rcapaverde/z80board/doc/Z80_schematics/74hc244_Joypad_schematics.PNG

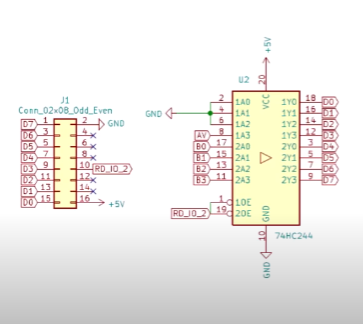
doc/Z80_schematics/74hc244_Joypad_schematics.PNG
