rcapaverde/z80board/doc/Z80_schematics/KEYBOARD_55_KEYS_v1.0_schema-1.png

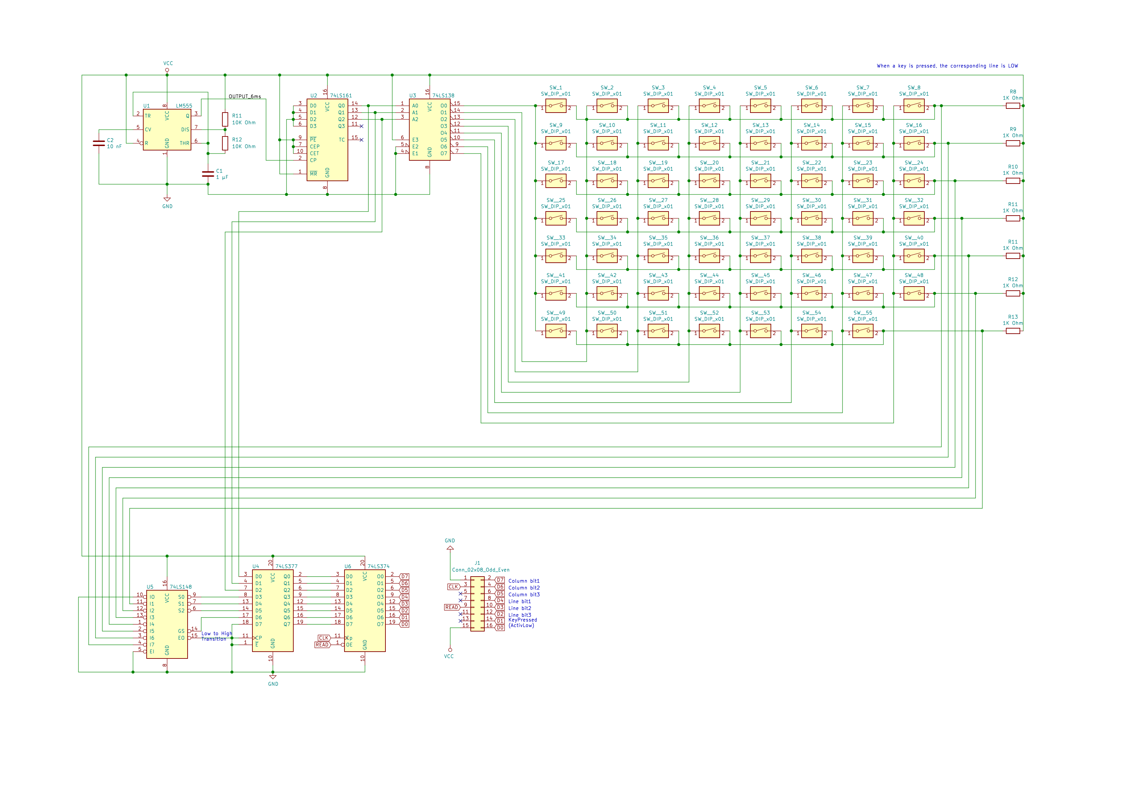
doc/Z80_schematics/KEYBOARD_55_KEYS_v1.0_schema-1.png
