rcapaverde/z80board/doc/Z80_schematics/kicad_schematics-1.png

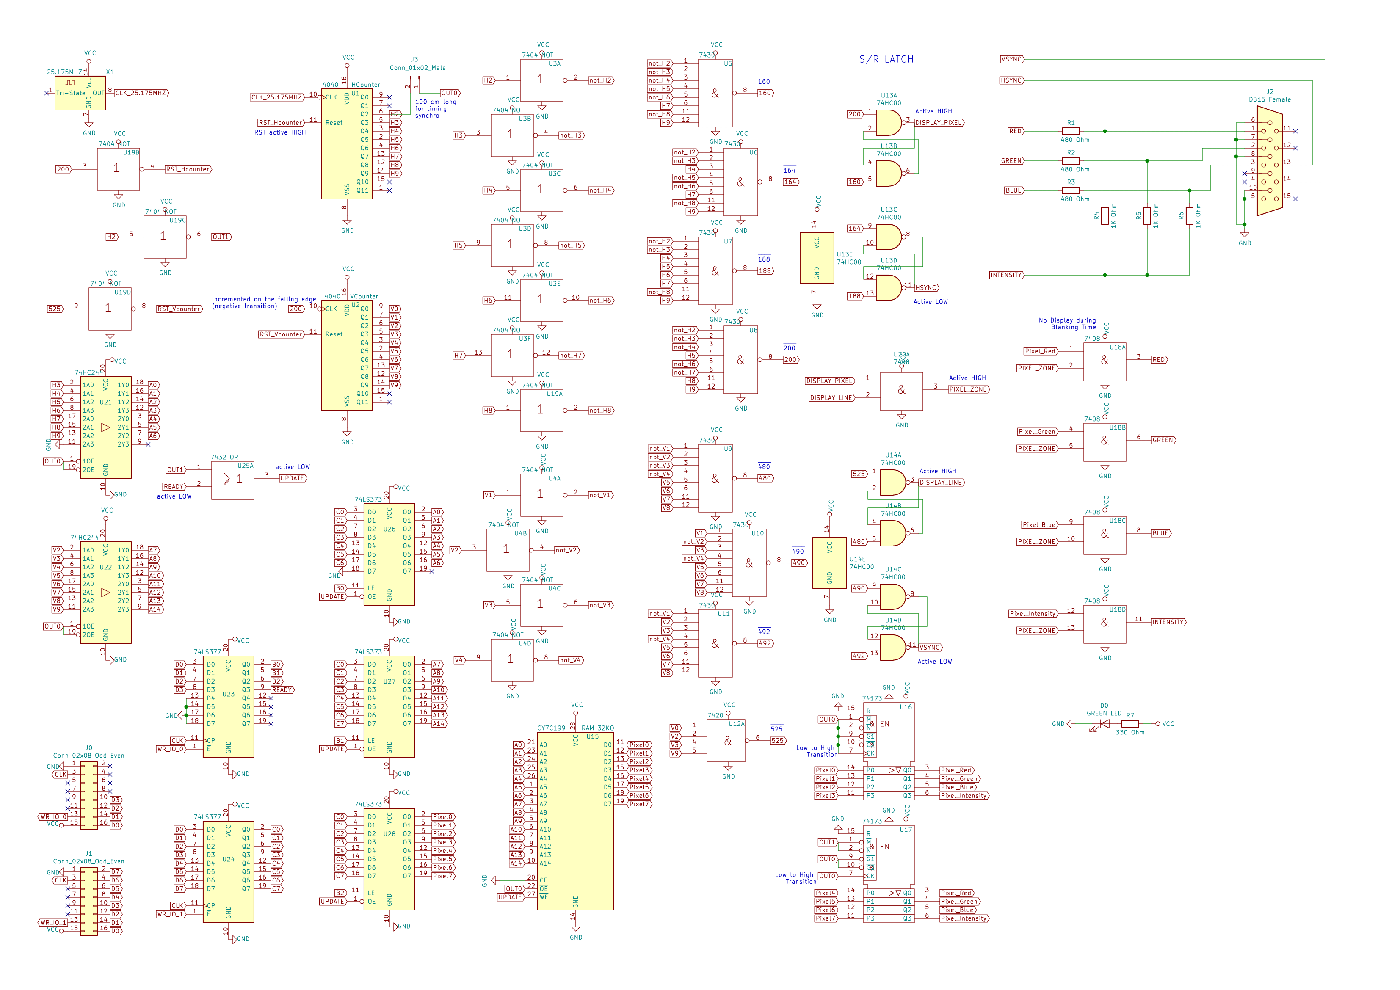
doc/Z80_schematics/kicad_schematics-1.png
