rcapaverde/z80board/doc/Z80_schematics/Keypad_interface.pdf

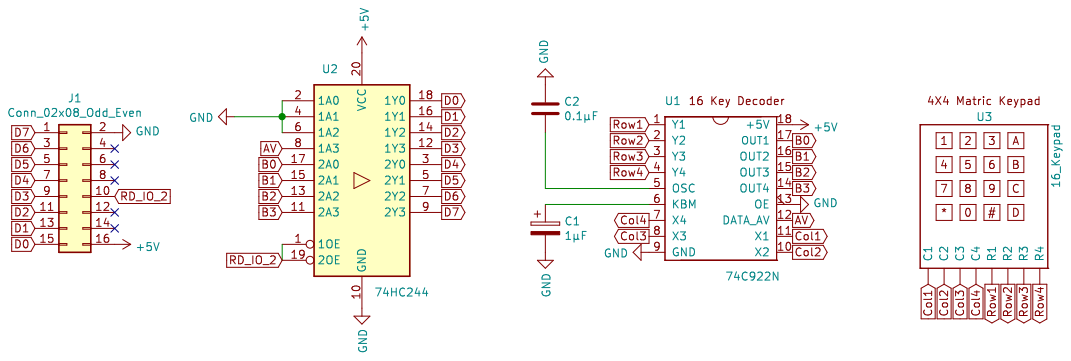
[picture p4: page 1]
