rcapaverde/z80board/doc/Z80_schematics/LCD_128x64_interface.pdf

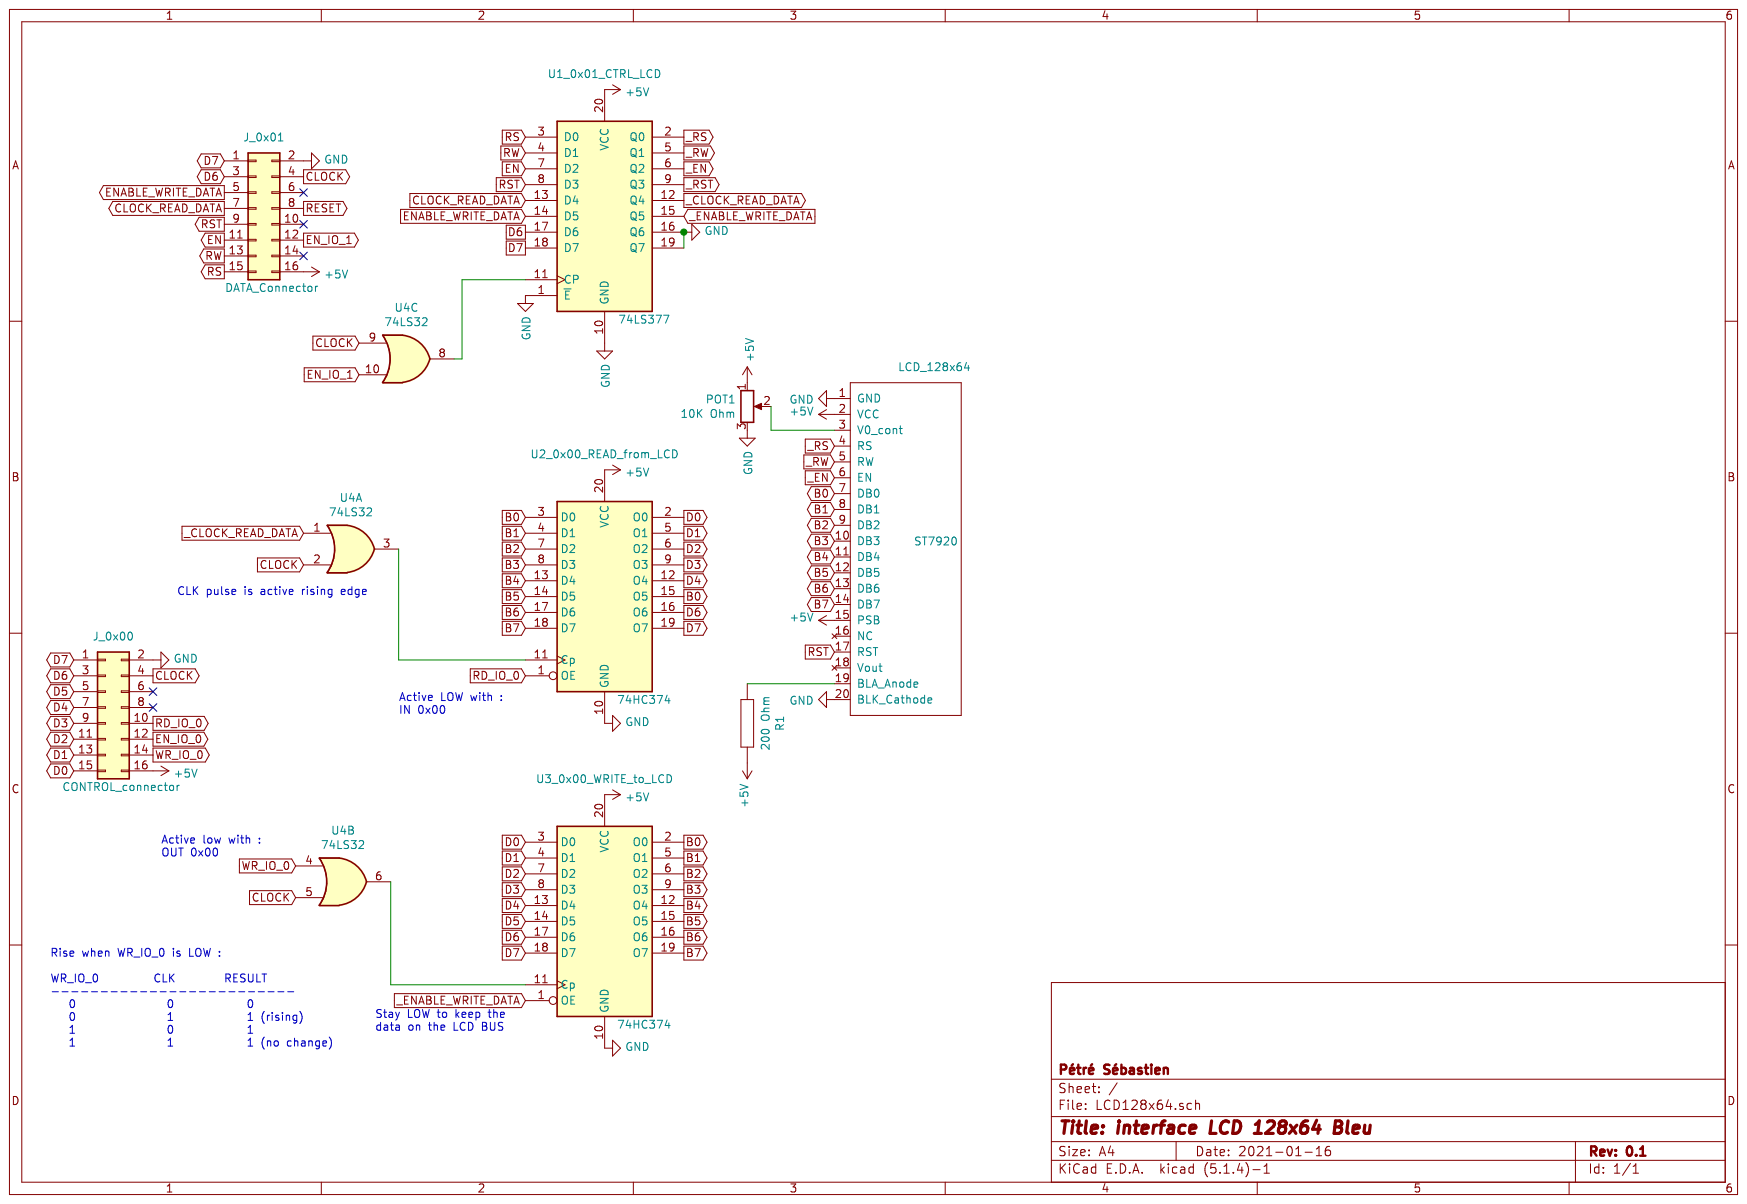
[picture p5: page 1]
