rcapaverde/z80board/doc/Z80_schematics/LCD_128x64_WriteOnly_interface.pdf

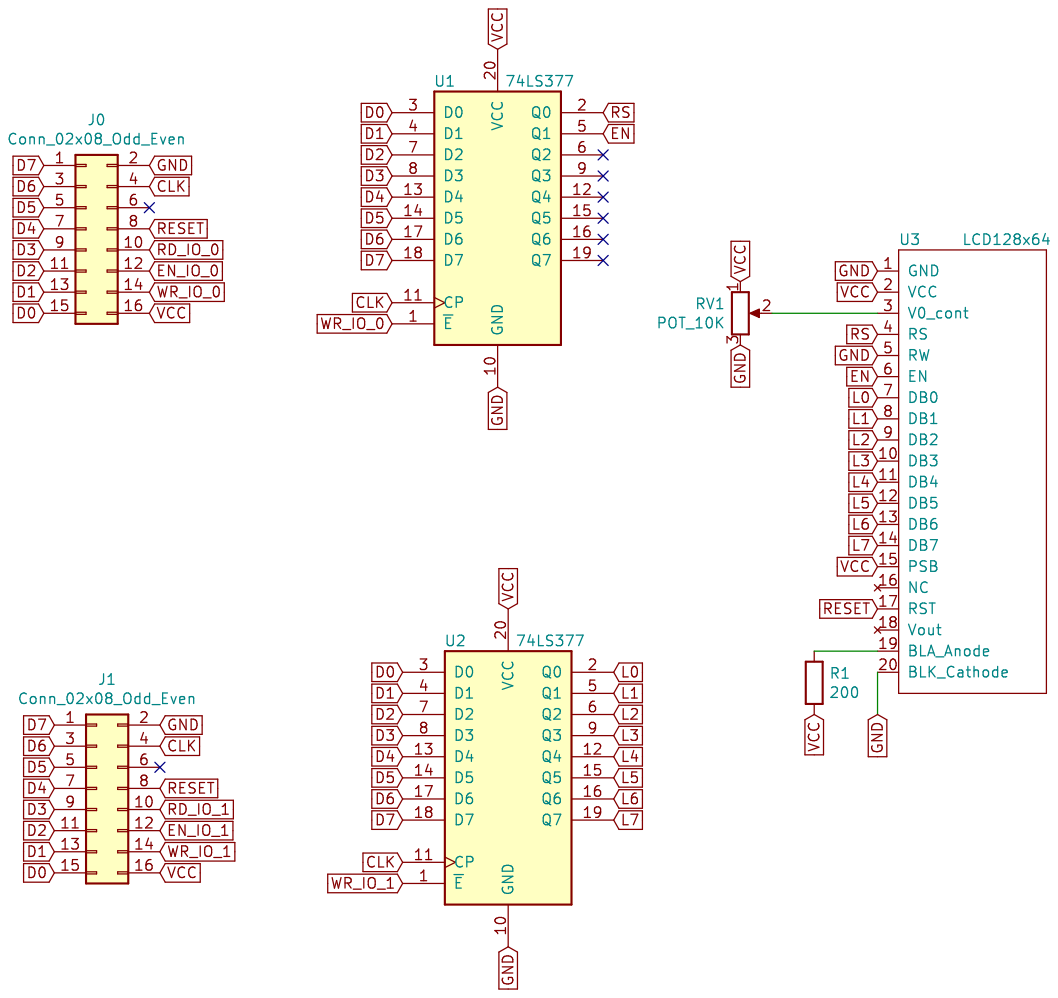
[picture p6: page 1]
