rcapaverde/z80board/doc/Z80_schematics/LCD_20x04_interface.pdf

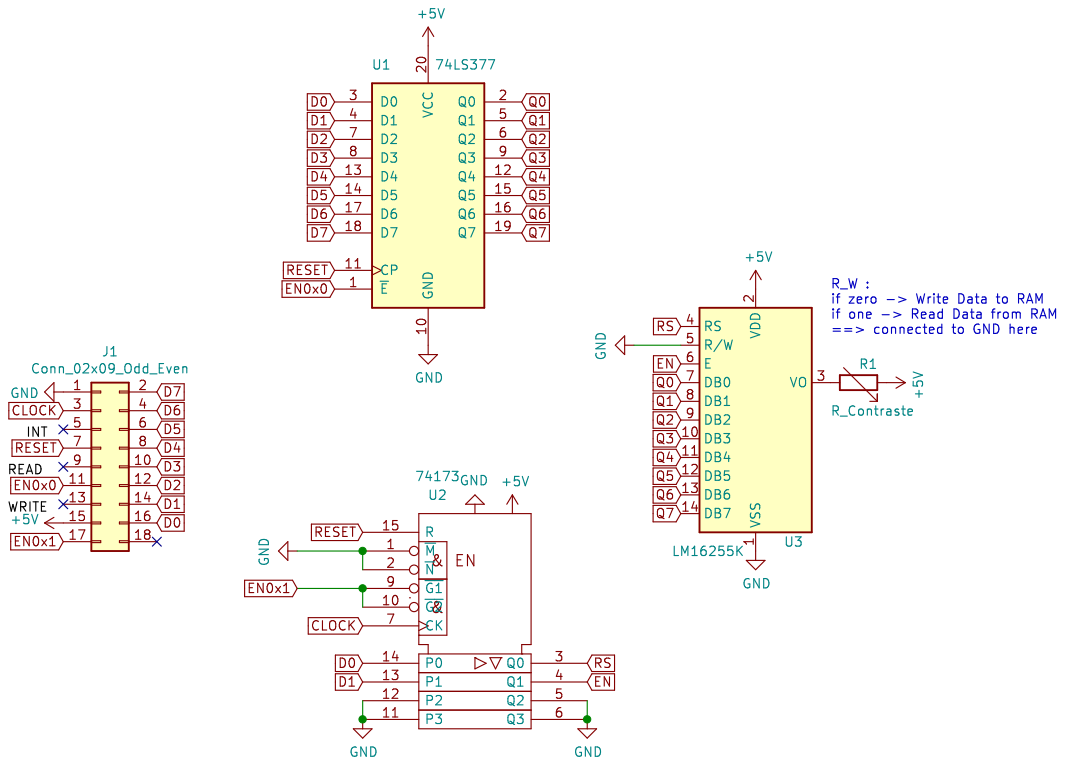
[picture p7: page 1]
