rcapaverde/z80board/doc/Z80_schematics/LED_test_interface.pdf

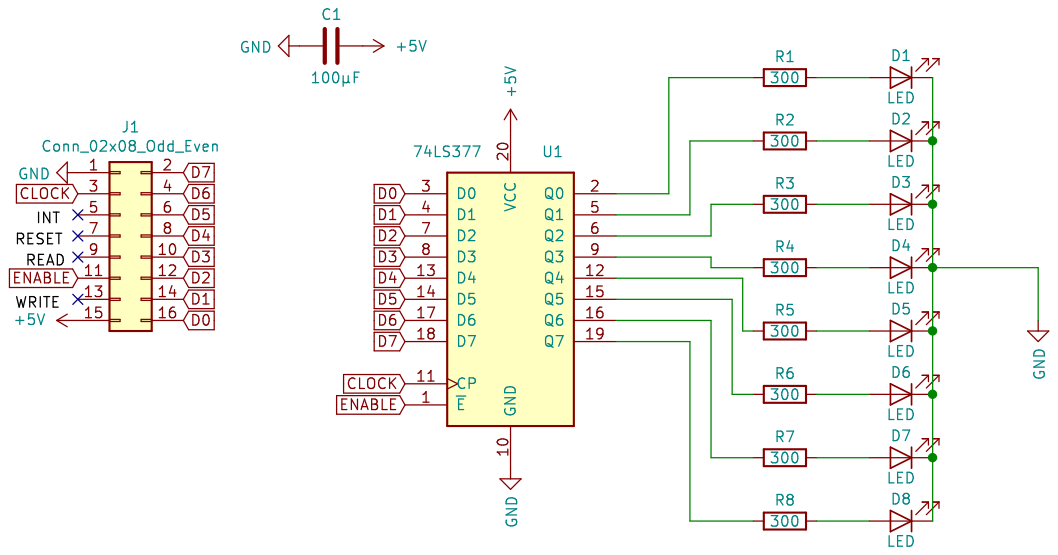
[picture p8: page 1]
