rcapaverde/z80board/doc/Z80_schematics/reset_V2.pdf

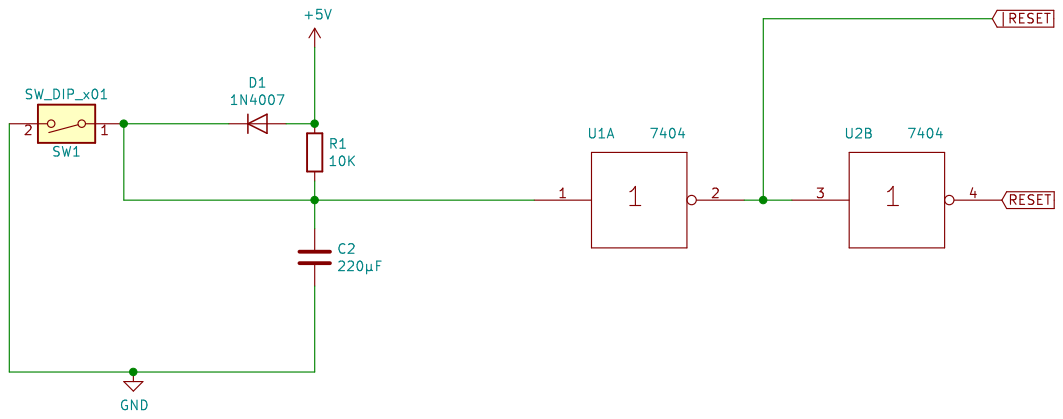
[picture p9: page 1]
