rcapaverde/z80board/doc/Z80_schematics/Schema_Rom_64kbyte_v0.3_img.pdf

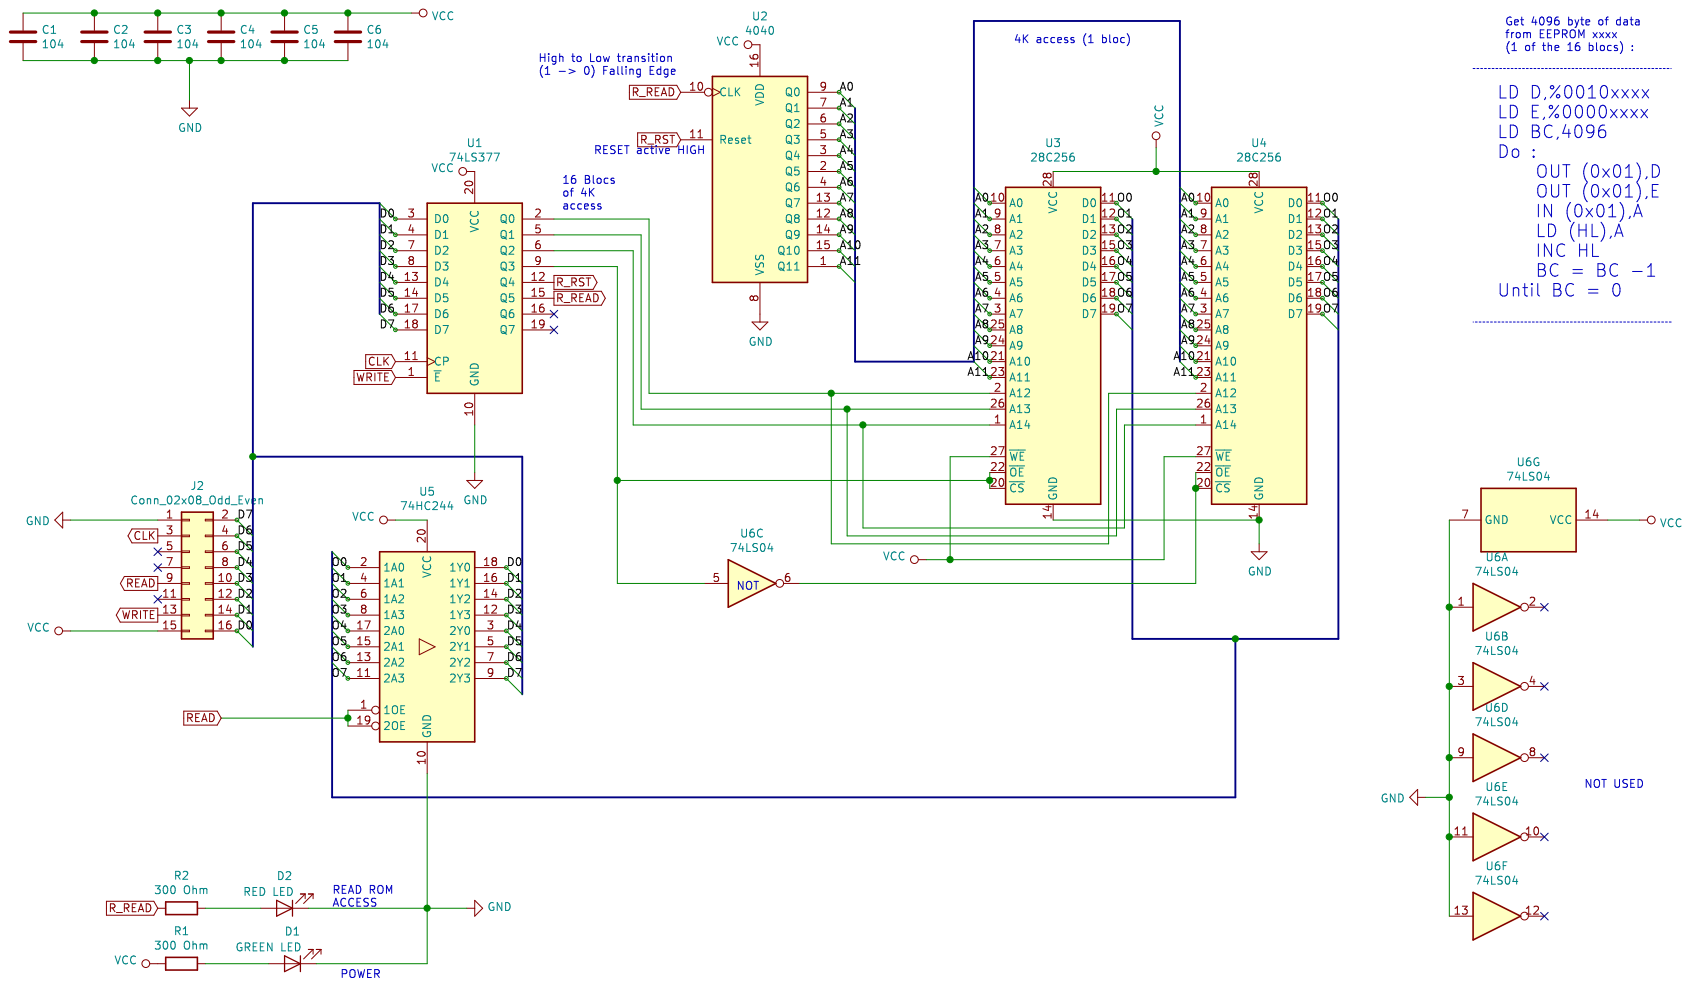
[picture p10: page 1]
