rcapaverde/z80board/doc/Z80_schematics/Speaker_interface.pdf

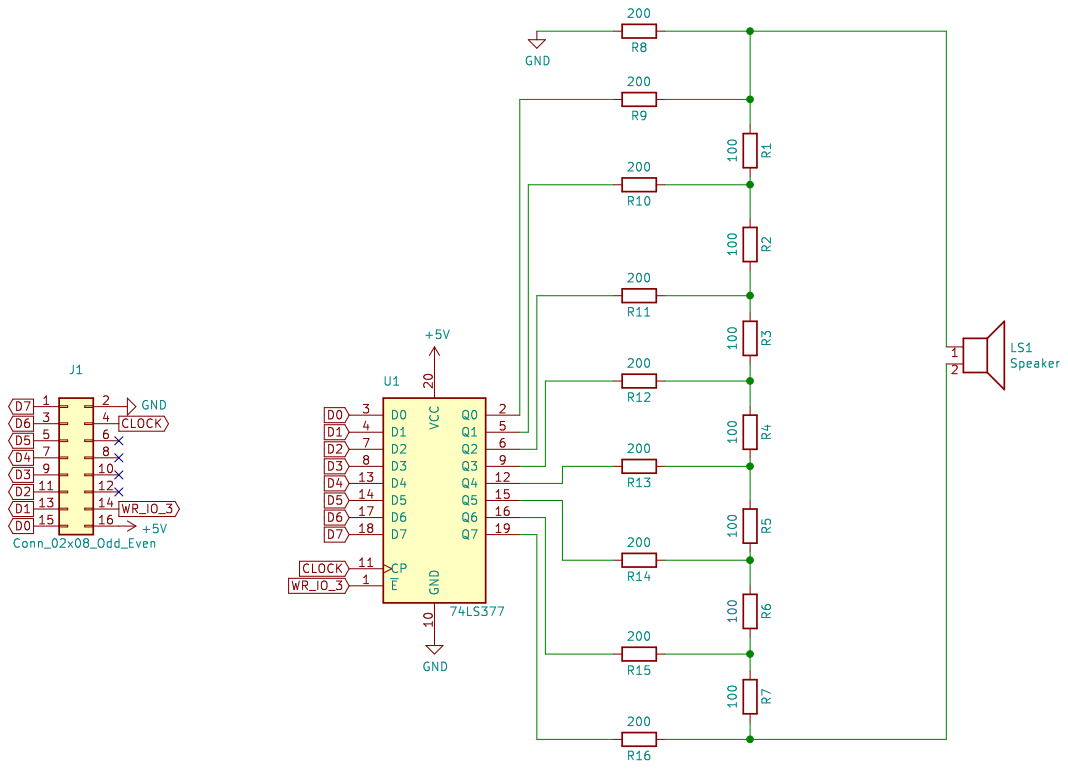
[picture p11: page 1]
