rcapaverde/z80board/doc/Z80_schematics/Video_display_160x120x16c_V1.3.pdf

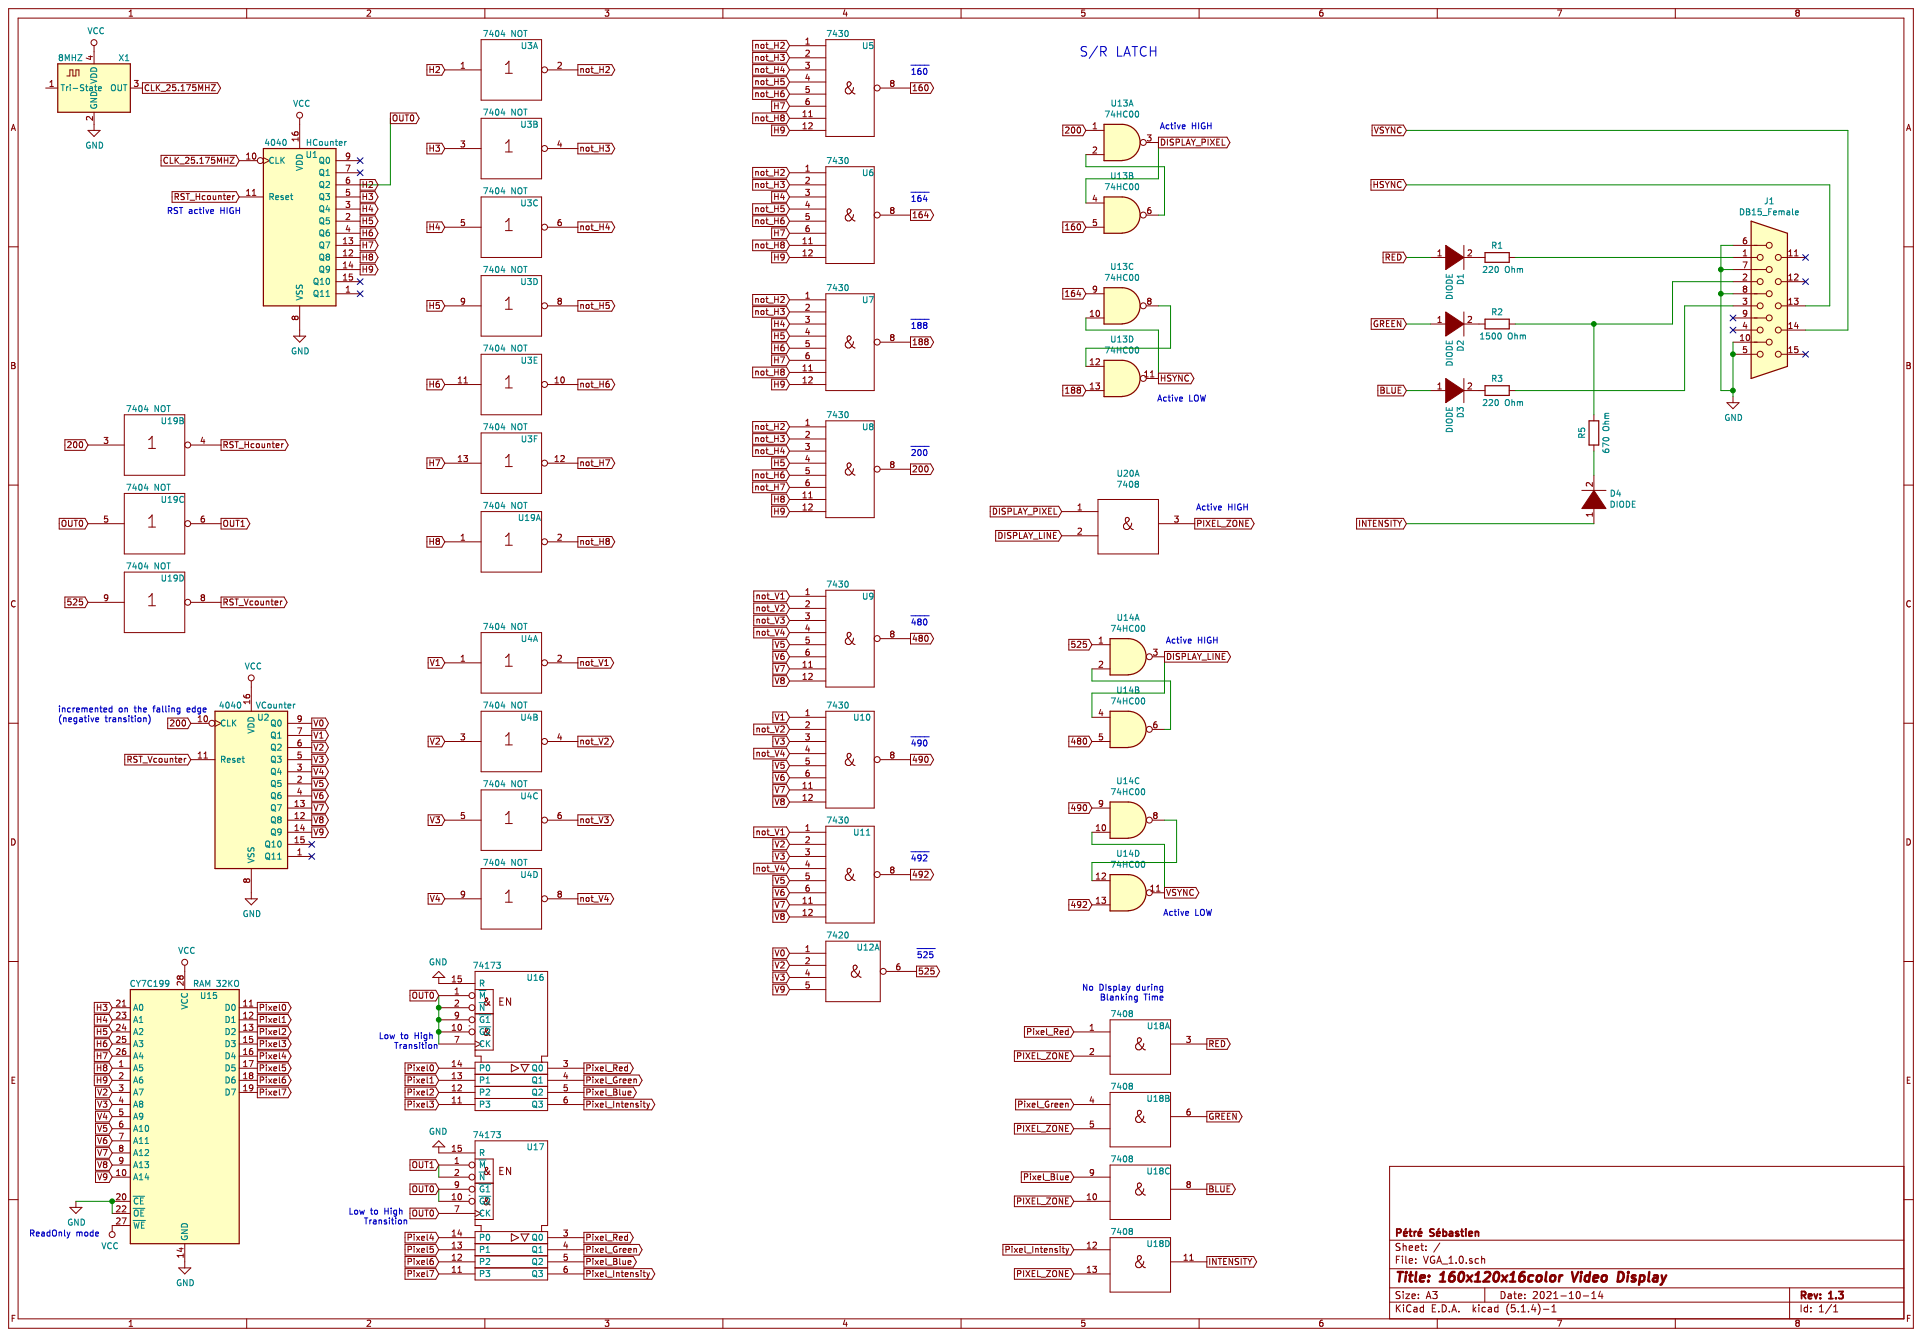
[picture p12: page 1]
