rcapaverde/z80board/doc/Z80_schematics/Video_display_160x120x16c_Z80_connexion_V1.5.pdf

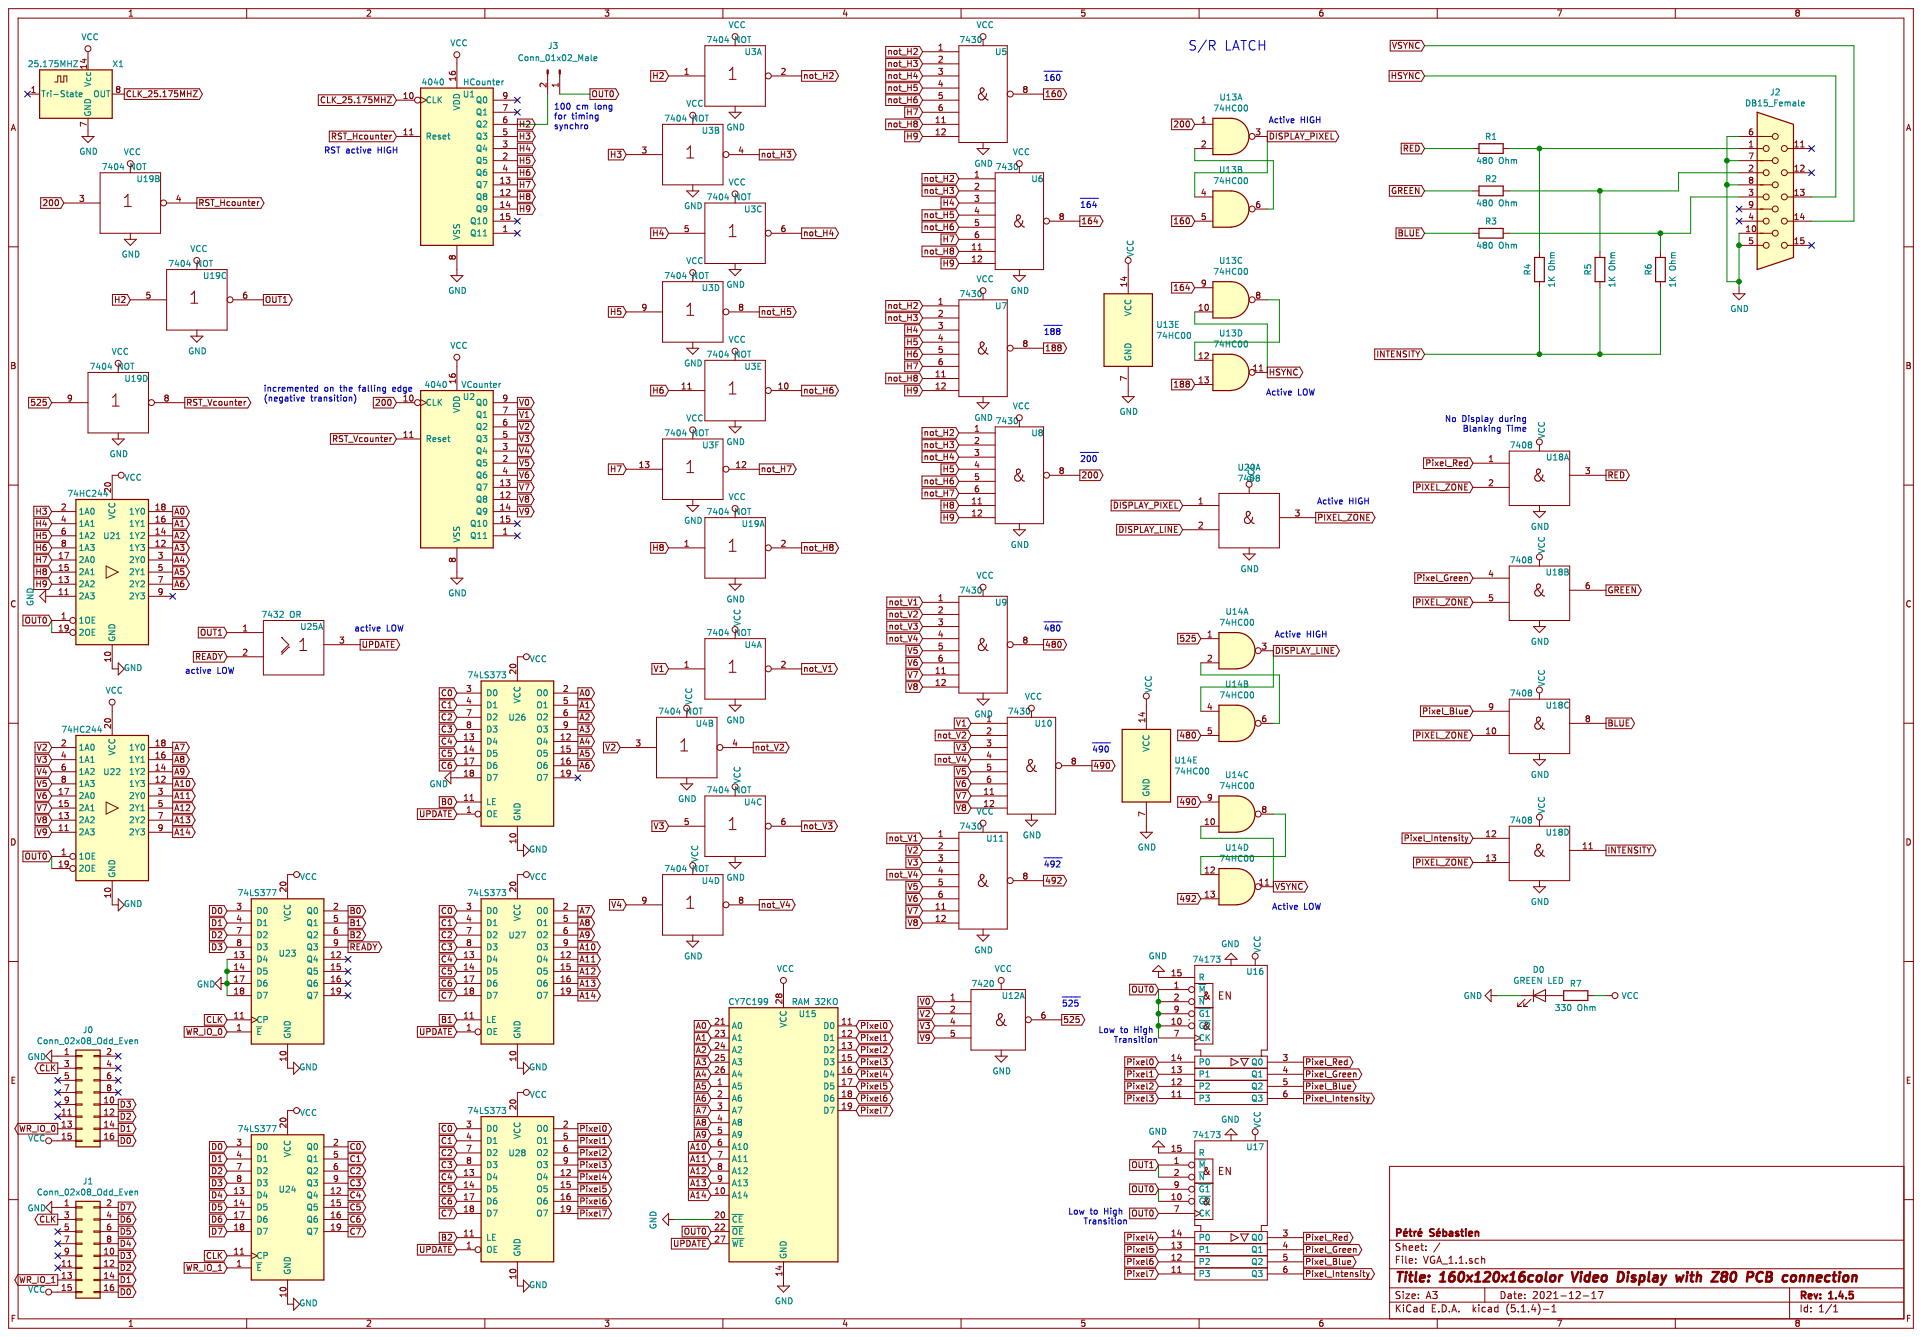
[picture p13: page 1]
