rcapaverde/z80board/doc/Z80_schematics/YM2413_v1.0.pdf

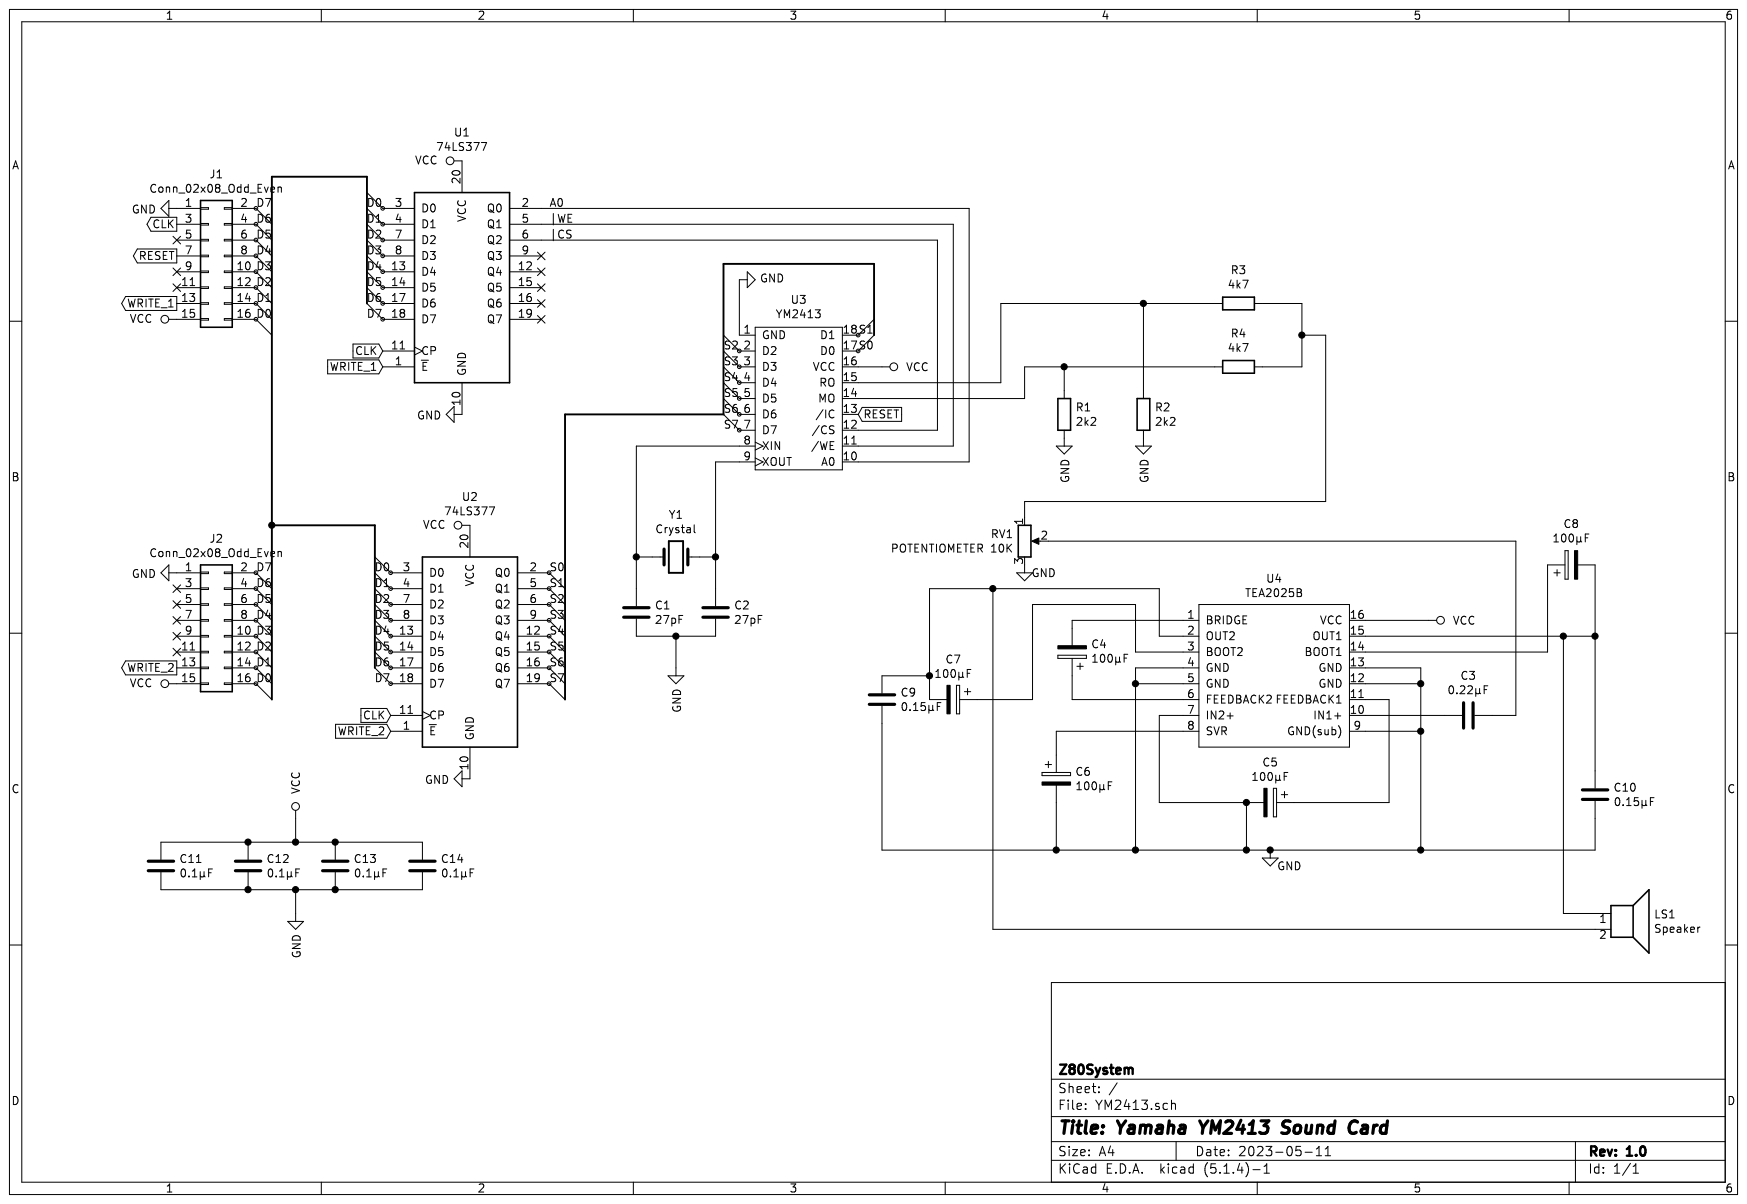
[picture p14: page 1]
