rcapaverde/z80board/doc/Z80_schematics/Z80_Motherboard.pdf

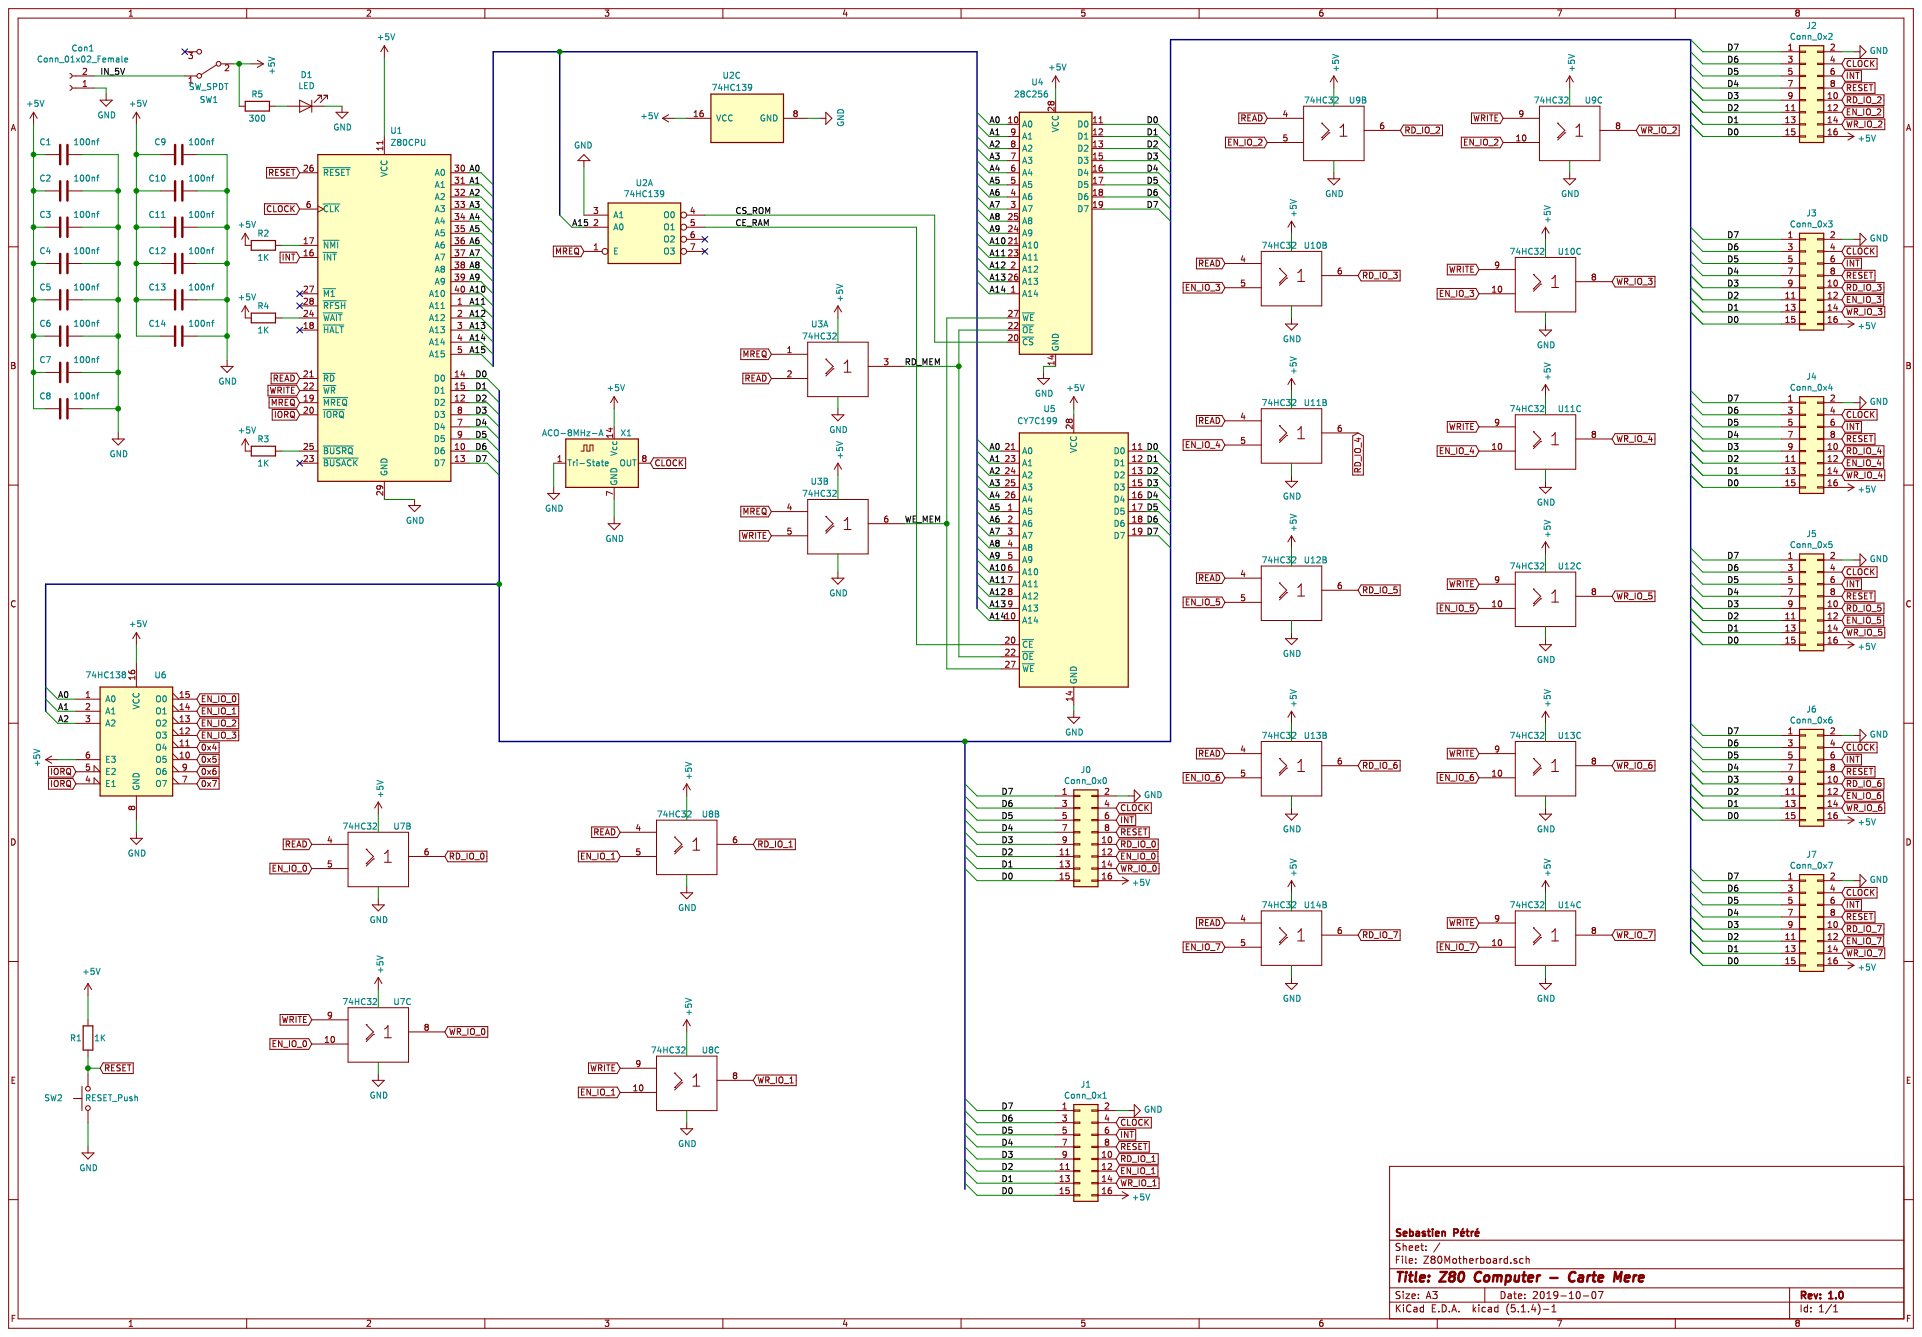
[picture p15: page 1]
