rcapaverde/z80board/doc/Z80_schematics/Z80_Motherboard_V2.pdf

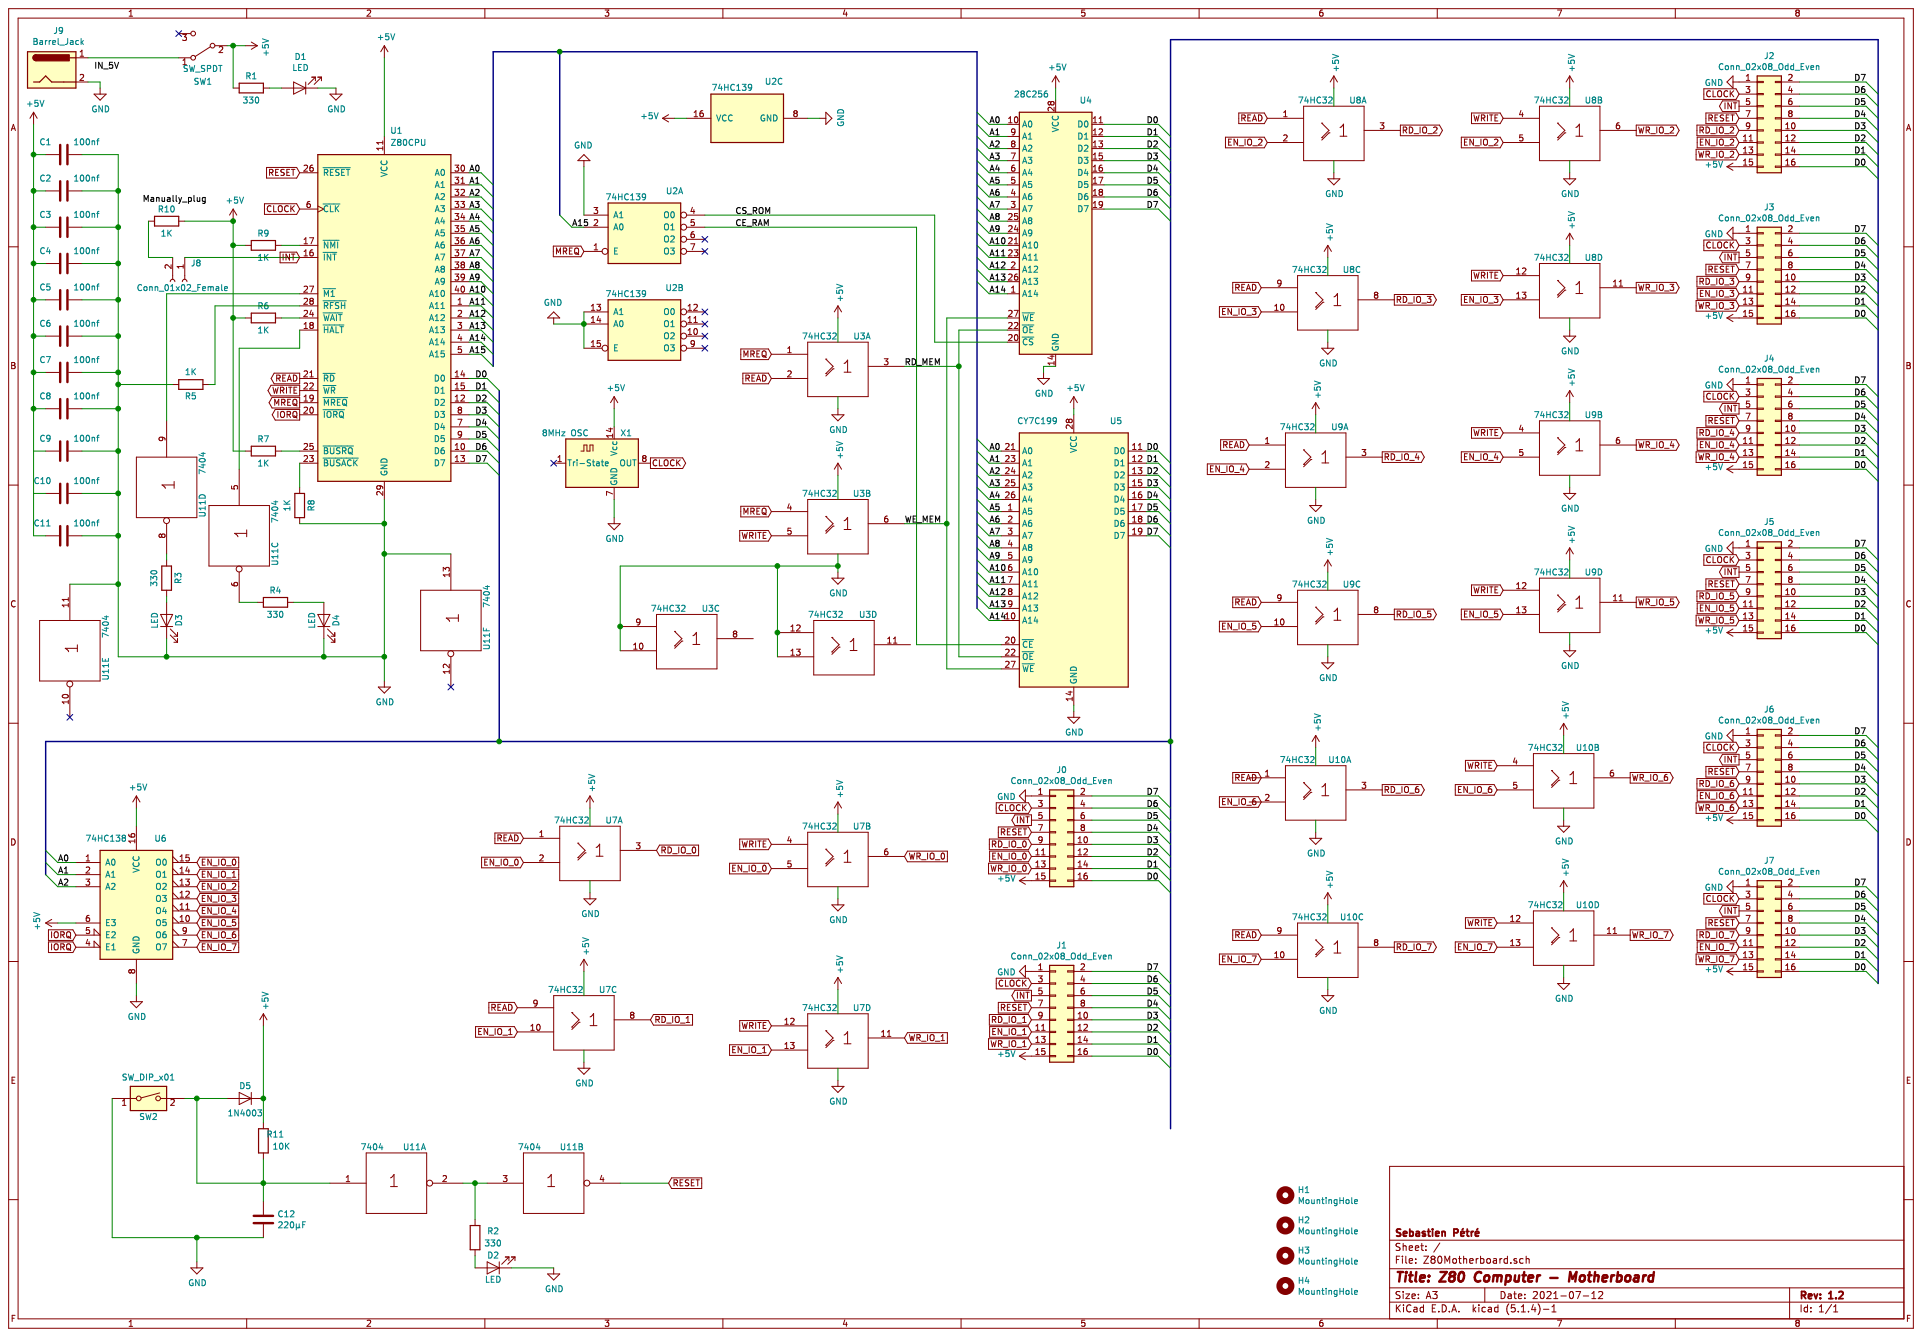
[picture p16: page 1]
