rcapaverde/z80board/doc/Z80_schematics/reset_old.pdf

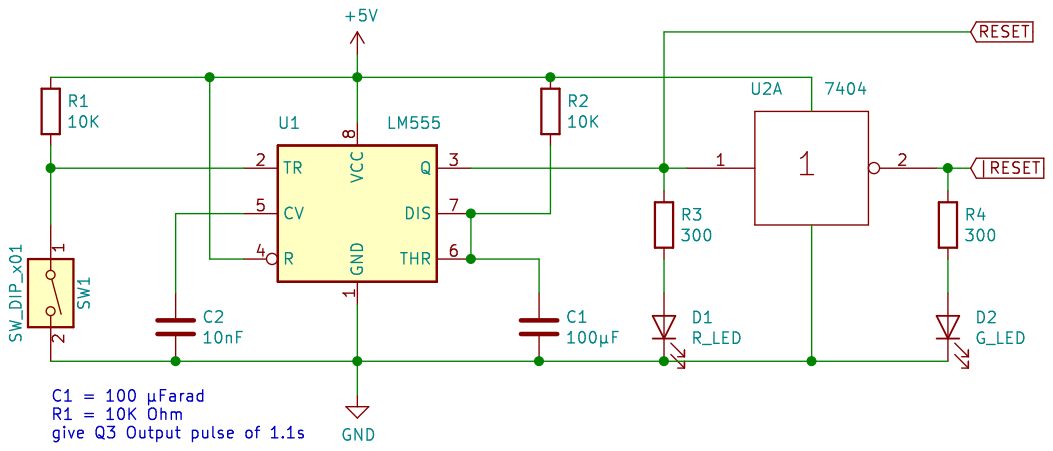
[picture p17: page 1]
