rcapaverde/z80board/pcb_v0/mainboard_v0/mainboard_v0.kicad_pcb

## KiCad design pcb_v0/mainboard_v0/mainboard_v0.kicad_pcb (2026-08-21)

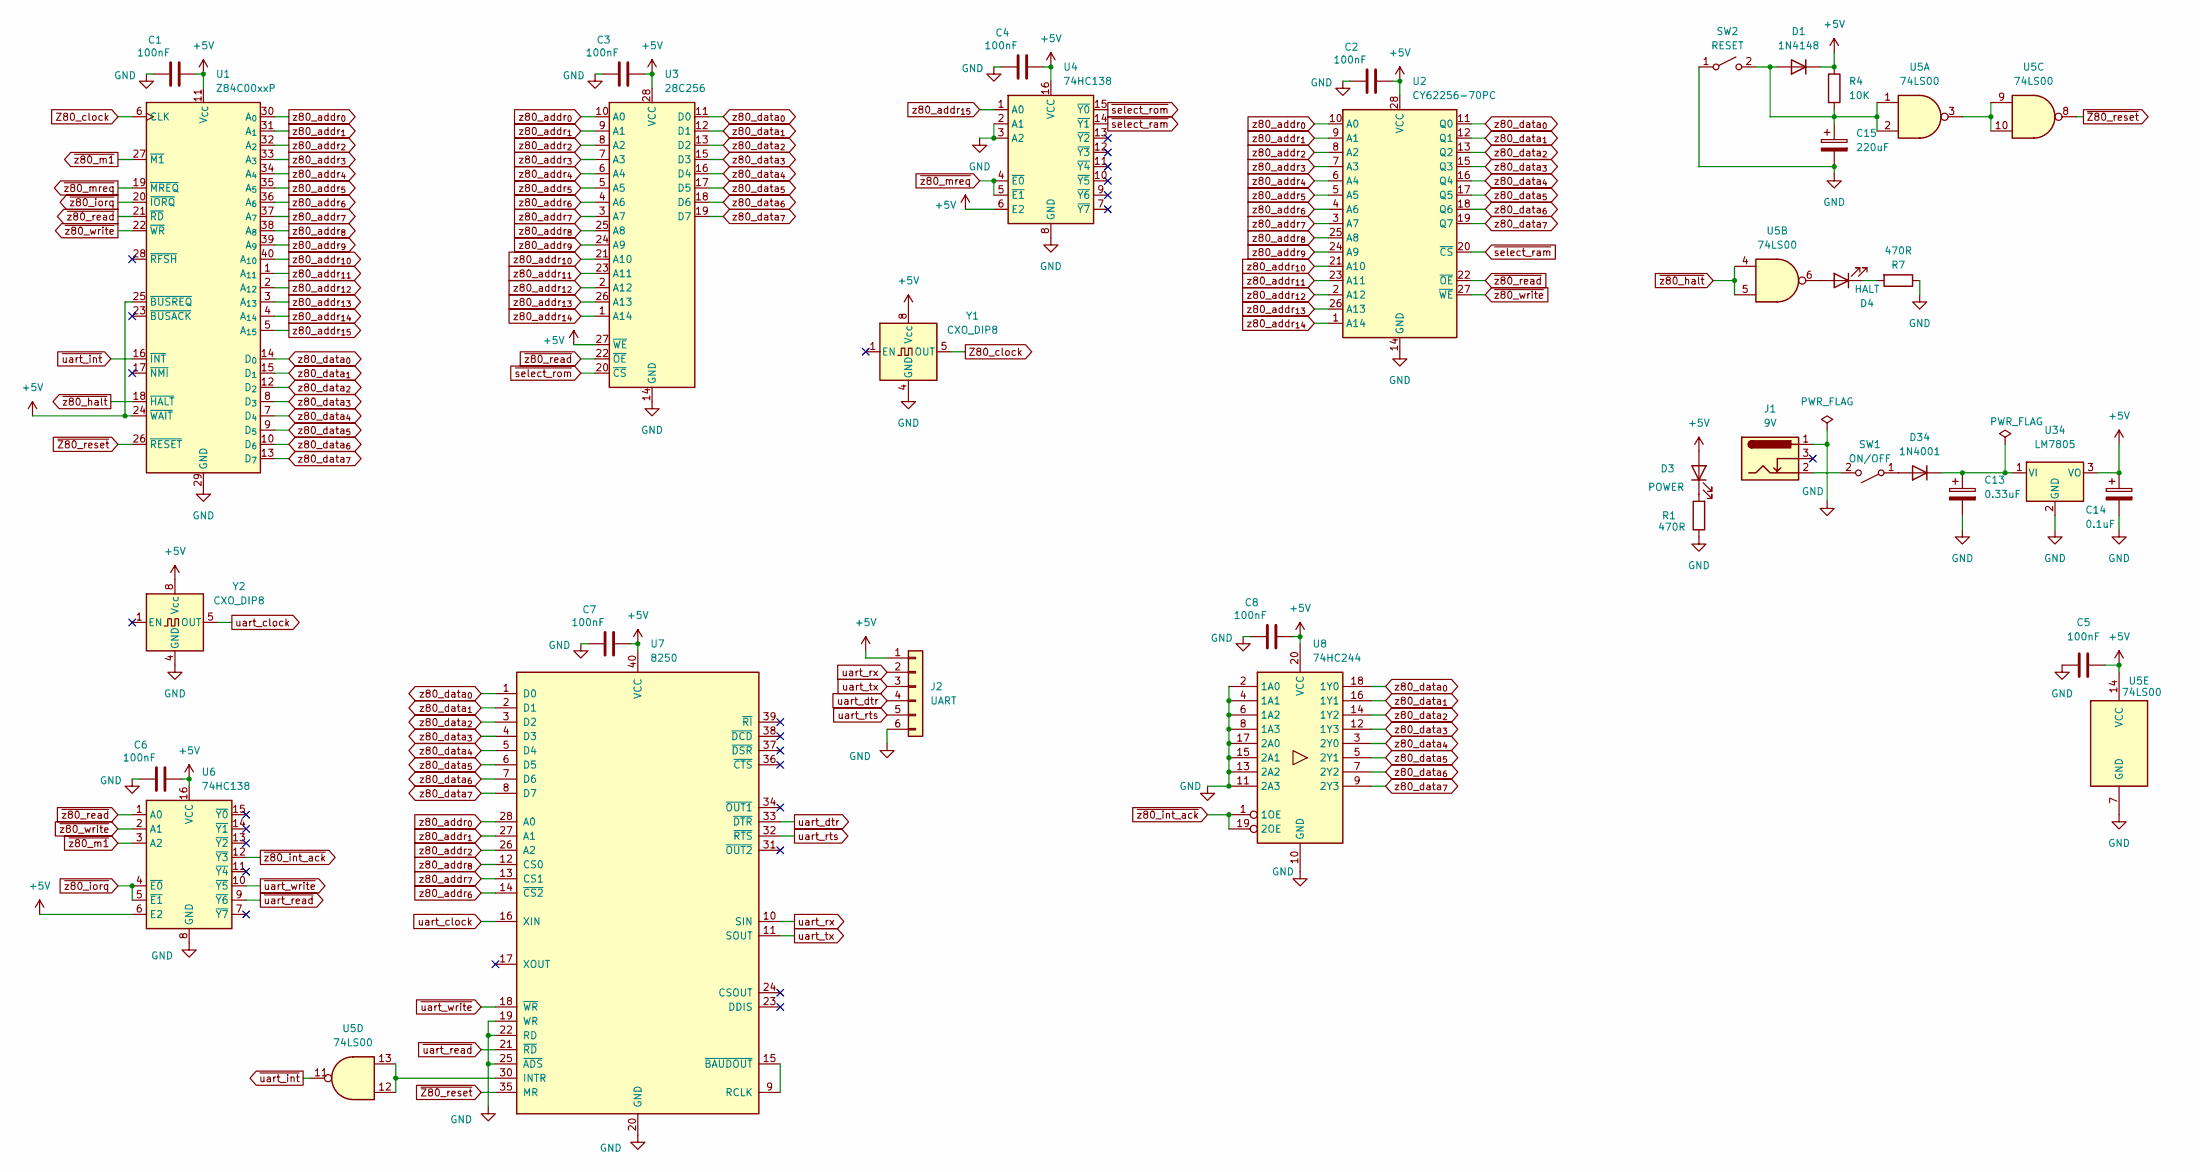
[picture p19: schematic mainboard_v0.kicad_sch]

Parts:
C1, C2, C3, C4, C5, C6, C7, C8: 100nF; C_Disc_D5.1mm_W3.2mm_P5.00mm
C13: 0.33uF; CP_Radial_D5.0mm_P2.50mm
C14: 0.1uF; CP_Radial_D5.0mm_P2.50mm
C15: 220uF; C_Disc_D5.1mm_W3.2mm_P5.00mm
D1: 1N4148; D_DO-35_SOD27_P7.62mm_Horizontal
D3: POWER; LED_D5.0mm
D4: HALT; LED_D5.0mm
D34: 1N4001; D_DO-41_SOD81_P10.16mm_Horizontal
J1: 9V; BarrelJack_Horizontal
J2: UART; PinHeader_1x06_P2.54mm_Vertical
R1, R7: 470R; R_Axial_DIN0207_L6.3mm_D2.5mm_P7.62mm_Horizontal
R4: 10K; R_Axial_DIN0207_L6.3mm_D2.5mm_P7.62mm_Horizontal
SW1: ON/OFF; jrx
SW2: RESET; SW_PUSH_6mm
U1: Z84C00xxP; DIP-40_W15.24mm
U2: CY62256-70PC; DIP-28_W15.24mm
U3: 28C256; DIP_Socket-28_W6.9mm_W7.62mm_W10.16mm_W12.7mm_W13.5mm_3M_22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
U4, U6: 74HC138; DIP-16_W7.62mm
U5: 74LS00; DIP-14_W7.62mm
U7: 8250; DIP-40_W15.24mm
U8: 74HC244; DIP-20_W7.62mm
U34: LM7805; TO-220-3_Vertical
Y1, Y2: CXO_DIP8; Oscillator_DIP-8

Connections:
+5V: C1.2, C2.2, C3.2, C4.2, C5.2, C6.2, C7.2, C8.2, C14.1, D1.1 (K), D3.2 (A), J2.1, R4.1, U1.11 (V_{CC}), U1.24 (~WAIT), U1.25 (~BUSREQ), U2.28 (VCC), U3.27 (~WE), U3.28 (VCC), U4.6 (E2), U4.16 (VCC), U5.14 (VCC), U6.6 (E2), U6.16 (VCC), U7.40 (VCC), U8.20 (VCC), U34.3 (VO), Y1.8 (Vcc), Y2.8 (Vcc)
GND: C1.1, C2.1, C3.1, C4.1, C5.1, C6.1, C7.1, C8.1, C13.2, C14.2, C15.2, J1.1, J2.6, R1.1, R7.1, SW2.1 (A), U1.29 (GND), U2.14 (GND), U3.14 (GND), U4.2 (A1), U4.3 (A2), U4.8 (GND), U5.7 (GND), U6.8 (GND), U7.19 (WR), U7.20 (GND), U7.22 (RD), U7.25 (~ADS), U8.2 (1A0), U8.4 (1A1), U8.6 (1A2), U8.8 (1A3), U8.10 (GND), U8.11 (2A3), U8.13 (2A2), U8.15 (2A1), U8.17 (2A0), U34.2 (GND), Y1.4 (GND), Y2.4 (GND)
unnamed: C15.1, D1.2 (A), R4.2, SW2.2 (B), U5.1, U5.2
unnamed: D3.1 (K), R1.2
unnamed: D4.2 (A), U5.6
unnamed: D4.1 (K), R7.2
unnamed: D34.2 (A), SW1.1 (A)
unnamed: C13.1, D34.1 (K), U34.1 (VI)
unnamed: J1.2, SW1.2 (B)
unnamed: U5.3, U5.9, U5.10
unnamed: U5.12, U5.13, U7.30 (INTR)
unnamed: U7.9 (RCLK), U7.15 (~BAUDOUT)
Z80_clock: U1.6 (CLK), Y1.5 (OUT)
uart_clock: U7.16 (XIN), Y2.5 (OUT)
uart_dtr: J2.4, U7.33 (~DTR)
uart_rts: J2.5, U7.32 (~RTS)
uart_rx: J2.2, U7.10 (SIN)
uart_tx: J2.3, U7.11 (SOUT)
z80_addr_{0}: U1.30 (A_{0}), U2.10 (A0), U3.10 (A0), U7.28 (A0)
z80_addr_{1}: U1.31 (A_{1}), U2.9 (A1), U3.9 (A1), U7.27 (A1)
z80_addr_{2}: U1.32 (A_{2}), U2.8 (A2), U3.8 (A2), U7.26 (A2)
z80_addr_{3}: U1.33 (A_{3}), U2.7 (A3), U3.7 (A3)
z80_addr_{4}: U1.34 (A_{4}), U2.6 (A4), U3.6 (A4)
z80_addr_{5}: U1.35 (A_{5}), U2.5 (A5), U3.5 (A5)
z80_addr_{6}: U1.36 (A_{6}), U2.4 (A6), U3.4 (A6), U7.14 (~CS2)
z80_addr_{7}: U1.37 (A_{7}), U2.3 (A7), U3.3 (A7), U7.13 (CS1)
z80_addr_{8}: U1.38 (A_{8}), U2.25 (A8), U3.25 (A8), U7.12 (CS0)
z80_addr_{9}: U1.39 (A_{9}), U2.24 (A9), U3.24 (A9)
z80_addr_{10}: U1.40 (A_{10}), U2.21 (A10), U3.21 (A10)
z80_addr_{11}: U1.1 (A_{11}), U2.23 (A11), U3.23 (A11)
z80_addr_{12}: U1.2 (A_{12}), U2.2 (A12), U3.2 (A12)
z80_addr_{13}: U1.3 (A_{13}), U2.26 (A13), U3.26 (A13)
z80_addr_{14}: U1.4 (A_{14}), U2.1 (A14), U3.1 (A14)
z80_addr_{15}: U1.5 (A_{15}), U4.1 (A0)
z80_data_{0}: U1.14 (D_{0}), U2.11 (Q0), U3.11 (D0), U7.1 (D0), U8.18 (1Y0)
z80_data_{1}: U1.15 (D_{1}), U2.12 (Q1), U3.12 (D1), U7.2 (D1), U8.16 (1Y1)
z80_data_{2}: U1.12 (D_{2}), U2.13 (Q2), U3.13 (D2), U7.3 (D2), U8.14 (1Y2)
z80_data_{3}: U1.8 (D_{3}), U2.15 (Q3), U3.15 (D3), U7.4 (D3), U8.12 (1Y3)
z80_data_{4}: U1.7 (D_{4}), U2.16 (Q4), U3.16 (D4), U7.5 (D4), U8.3 (2Y0)
z80_data_{5}: U1.9 (D_{5}), U2.17 (Q5), U3.17 (D5), U7.6 (D5), U8.5 (2Y1)
z80_data_{6}: U1.10 (D_{6}), U2.18 (Q6), U3.18 (D6), U7.7 (D6), U8.7 (2Y2)
z80_data_{7}: U1.13 (D_{7}), U2.19 (Q7), U3.19 (D7), U7.8 (D7), U8.9 (2Y3)
~Z80_reset: U1.26 (~RESET), U5.8, U7.35 (MR)
~select_ram: U2.20 (~CS), U4.14 (~Y1)
~select_rom: U3.20 (~CS), U4.15 (~Y0)
~uart_int: U1.16 (~INT), U5.11
~uart_read: U6.9 (~Y6), U7.21 (~RD)
~uart_write: U6.10 (~Y5), U7.18 (~WR)
~z80_halt: U1.18 (~HALT), U5.4, U5.5
~z80_int_ack: U6.12 (~Y3), U8.1 (1OE), U8.19 (2OE)
~z80_iorq: U1.20 (~IORQ), U6.4 (~E0), U6.5 (~E1)
~z80_m1: U1.27 (~M1), U6.3 (A2)
~z80_mreq: U1.19 (~MREQ), U4.4 (~E0), U4.5 (~E1)
~z80_read: U1.21 (~RD), U2.22 (~OE), U3.22 (~OE), U6.1 (A0)
~z80_write: U1.22 (~WR), U2.27 (~WE), U6.2 (A1)

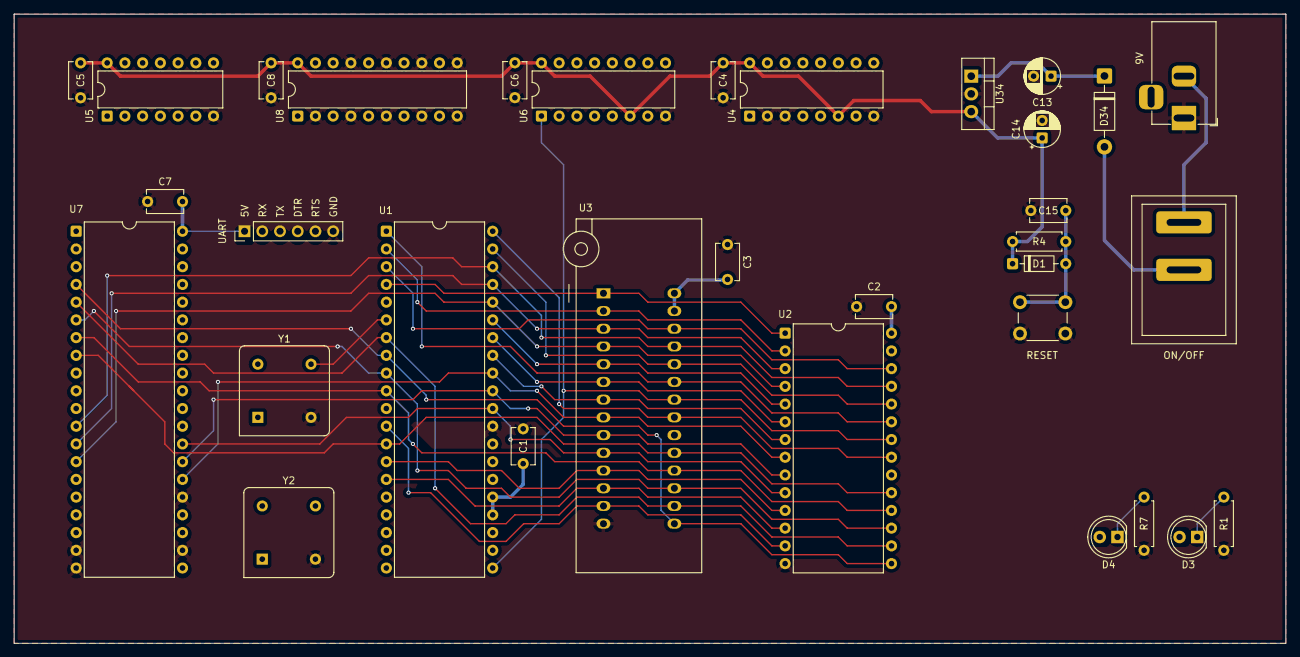
[picture p20: board mainboard_v0.kicad_pcb from above]

Board: 2 copper layers, 182.2 x 90.2 mm, 33 parts (0 on the bottom side), 55 nets.
