rcapaverde/z80board/pcb/mainboard/mainboard.kicad_pcb

## KiCad design pcb/mainboard/mainboard.kicad_pcb (2026-08-15, an earlier design)

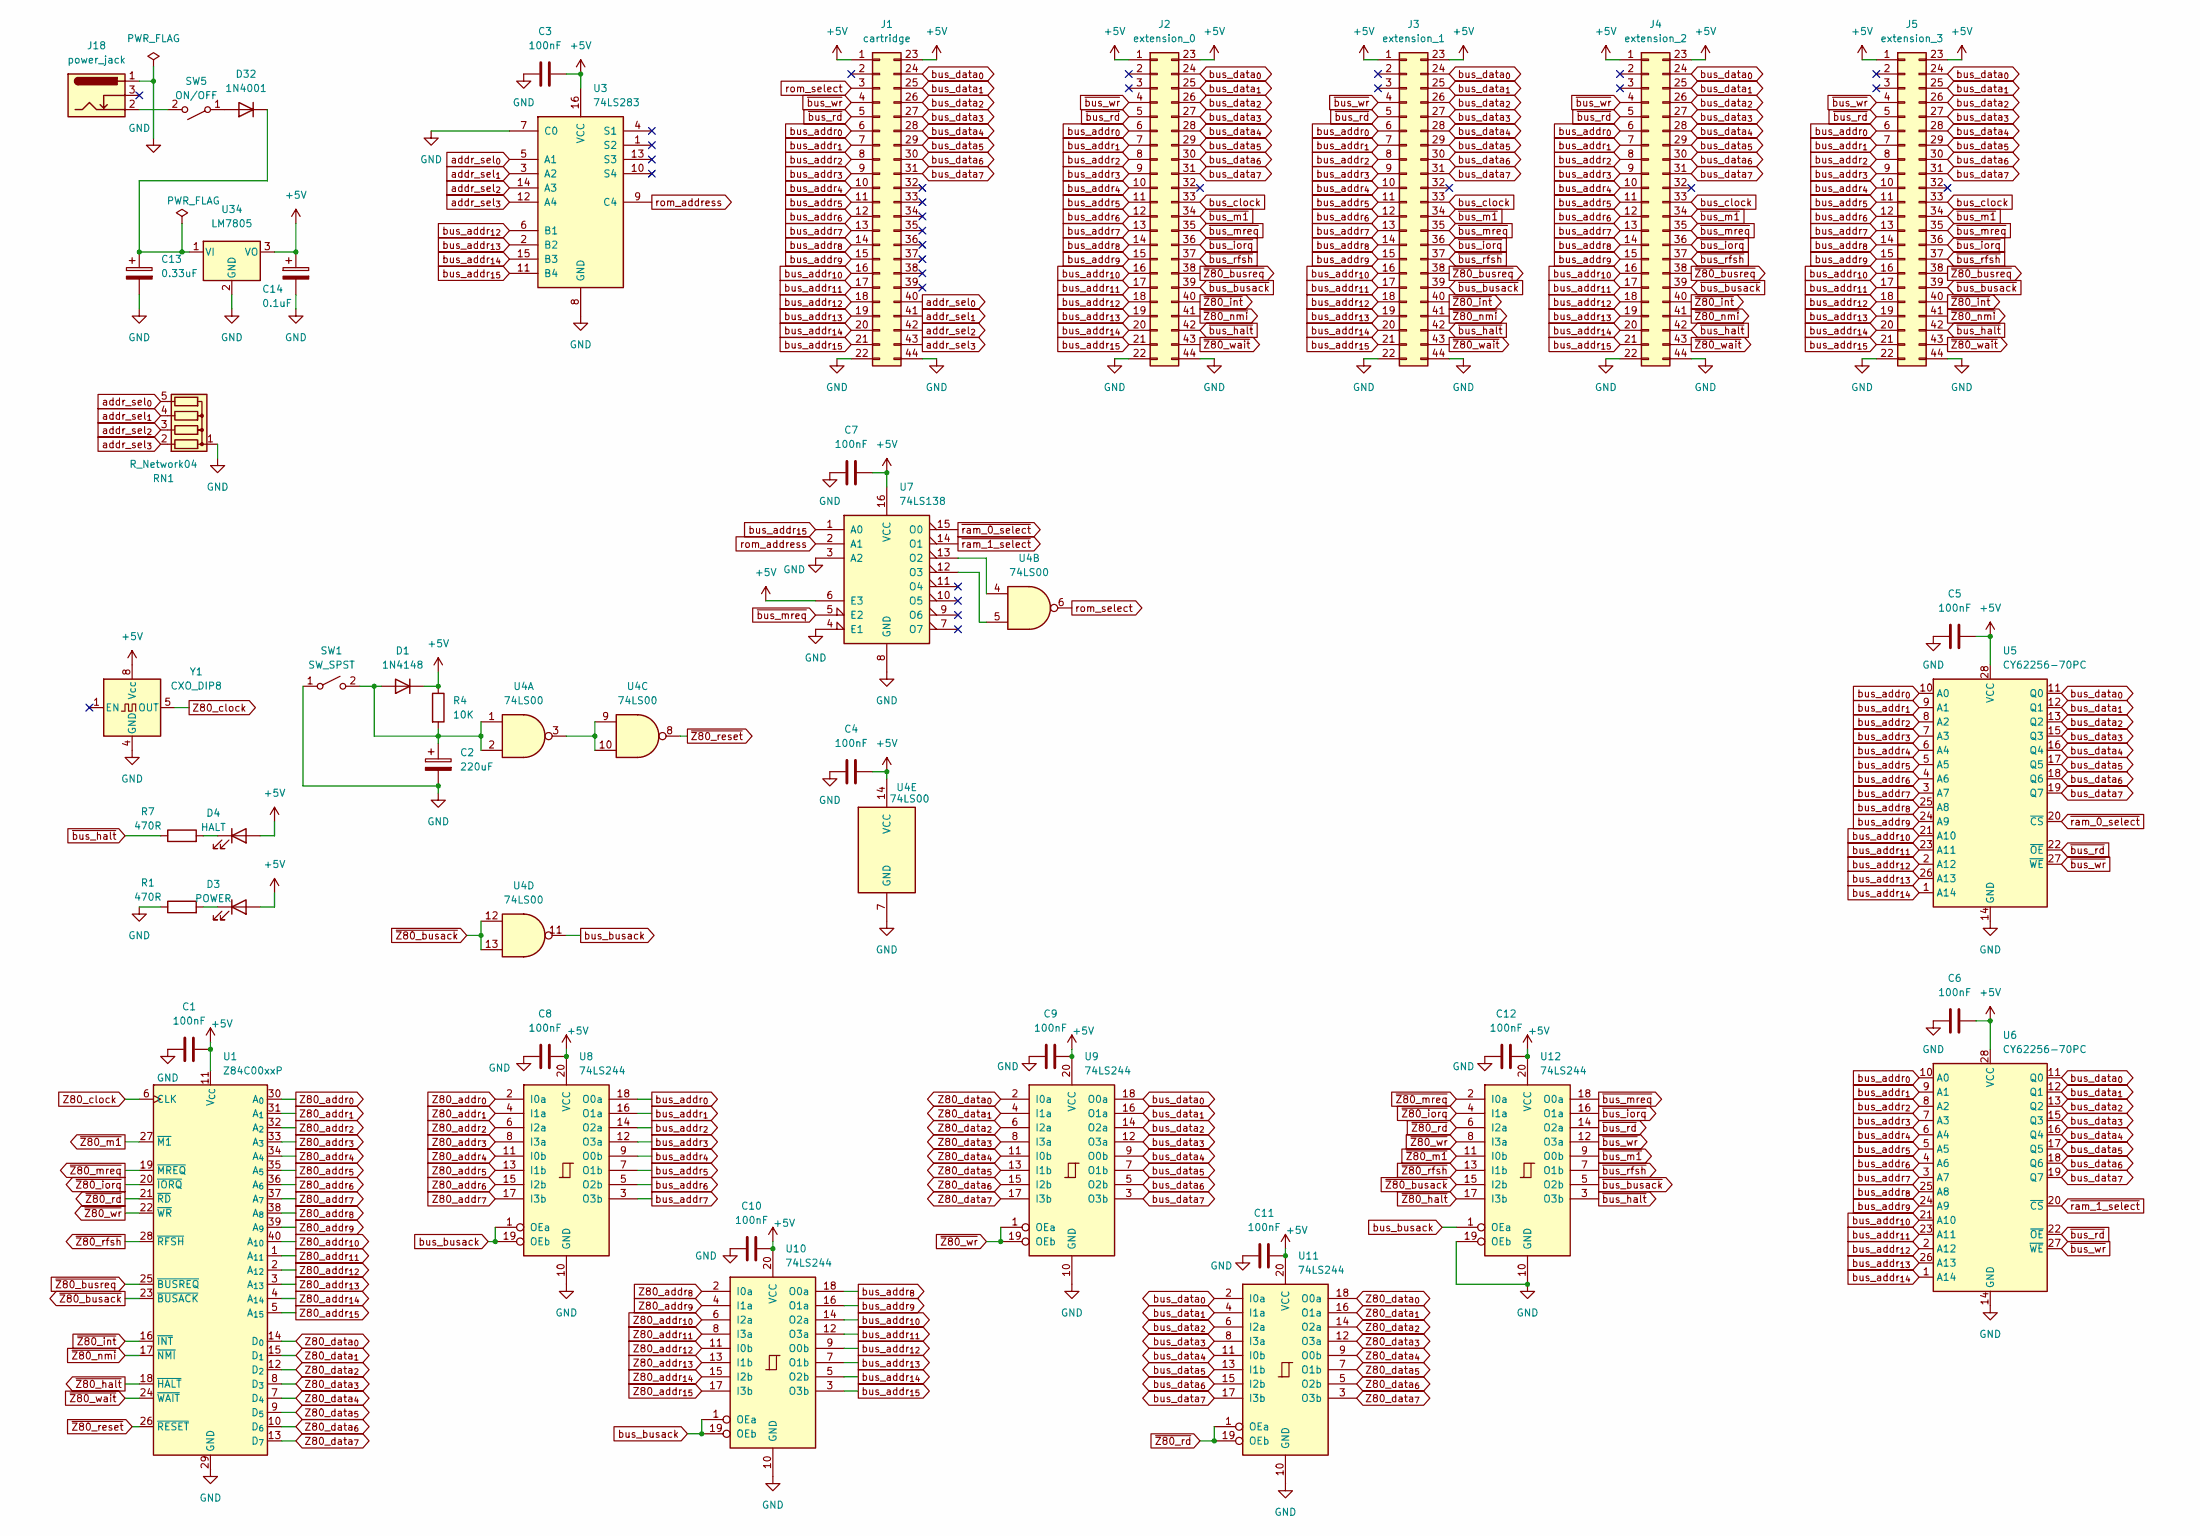
[picture p21: schematic mainboard.kicad_sch]

Parts:
C1, C3, C4, C5, C6, C7, C8, C9, C10, C11, C12: 100nF; C_Disc_D5.1mm_W3.2mm_P5.00mm
C2: 220uF; C_Disc_D5.1mm_W3.2mm_P5.00mm
C13: 0.33uF; CP_Radial_D5.0mm_P2.50mm
C14: 0.1uF; CP_Radial_D5.0mm_P2.50mm
D1: 1N4148; D_DO-35_SOD27_P7.62mm_Horizontal
D3: POWER; LED_D5.0mm
D4: HALT; LED_D5.0mm
D32: 1N4001; D_DO-41_SOD81_P10.16mm_Horizontal
J1: cartridge; male-edge-connector-44
J2: extension_0; male-edge-connector-44
J3: extension_1; male-edge-connector-44
J4: extension_2; male-edge-connector-44
J5: extension_3; male-edge-connector-44
J18: power_jack; BarrelJack_Horizontal
R1, R7: 470R; R_Axial_DIN0207_L6.3mm_D2.5mm_P7.62mm_Horizontal
R4: 10K; R_Axial_DIN0207_L6.3mm_D2.5mm_P7.62mm_Horizontal
RN1: R_Network04; R_Array_SIP5
SW1: SW_SPST; SW_PUSH_6mm
SW5: ON/OFF; jrx
U1: Z84C00xxP; DIP-40_W15.24mm
U3: 74LS283; DIP-16_W7.62mm
U4: 74LS00; DIP-14_W7.62mm
U5, U6: CY62256-70PC; DIP-28_W15.24mm
U7: 74LS138; DIP-16_W7.62mm
U8, U9, U10, U11, U12: 74LS244; DIP-20_W7.62mm
U34: LM7805; TO-220-3_Vertical
Y1: CXO_DIP8; Oscillator_DIP-8

Connections:
+5V: C1.2, C3.2, C4.2, C5.2, C6.2, C7.2, C8.2, C9.2, C10.2, C11.2, C12.2, C14.1, D1.1 (K), D3.2 (A), D4.2 (A), J1.1, J1.23, J2.1, J2.23, J3.1, J3.23, J4.1, J4.23, J5.1, J5.23, R4.1, U1.11 (V_{CC}), U3.16 (VCC), U4.14 (VCC), U5.28 (VCC), U6.28 (VCC), U7.6 (E3), U7.16 (VCC), U8.20 (VCC), U9.20 (VCC), U10.20 (VCC), U11.20 (VCC), U12.20 (VCC), U34.3 (VO), Y1.8 (Vcc)
GND: C1.1, C2.2, C3.1, C4.1, C5.1, C6.1, C7.1, C8.1, C9.1, C10.1, C11.1, C12.1, C13.2, C14.2, J1.22, J1.44, J2.22, J2.44, J3.22, J3.44, J4.22, J4.44, J5.22, J5.44, J18.1, R1.1, RN1.1 (common), SW1.1 (A), U1.29 (GND), U3.7 (C0), U3.8 (GND), U4.7 (GND), U5.14 (GND), U6.14 (GND), U7.3 (A2), U7.4 (E1), U7.8 (GND), U8.10 (GND), U9.10 (GND), U10.10 (GND), U11.10 (GND), U12.10 (GND), U12.19 (OEb), U34.2 (GND), Y1.4 (GND)
unnamed: C2.1, D1.2 (A), R4.2, SW1.2 (B), U4.1, U4.2
unnamed: D3.1 (K), R1.2
unnamed: D4.1 (K), R7.2
unnamed: D32.2 (A), SW5.1 (A)
unnamed: C13.1, D32.1 (K), U34.1 (VI)
unnamed: J18.2, SW5.2 (B)
unnamed: U4.3, U4.9, U4.10
unnamed: U4.4, U7.13 (O2)
unnamed: U4.5, U7.12 (O3)
Z80_addr_{0}: U1.30 (A_{0}), U8.2 (I0a)
Z80_addr_{1}: U1.31 (A_{1}), U8.4 (I1a)
Z80_addr_{2}: U1.32 (A_{2}), U8.6 (I2a)
Z80_addr_{3}: U1.33 (A_{3}), U8.8 (I3a)
Z80_addr_{4}: U1.34 (A_{4}), U8.11 (I0b)
Z80_addr_{5}: U1.35 (A_{5}), U8.13 (I1b)
Z80_addr_{6}: U1.36 (A_{6}), U8.15 (I2b)
Z80_addr_{7}: U1.37 (A_{7}), U8.17 (I3b)
Z80_addr_{8}: U1.38 (A_{8}), U10.2 (I0a)
Z80_addr_{9}: U1.39 (A_{9}), U10.4 (I1a)
Z80_addr_{10}: U1.40 (A_{10}), U10.6 (I2a)
Z80_addr_{11}: U1.1 (A_{11}), U10.8 (I3a)
Z80_addr_{12}: U1.2 (A_{12}), U10.11 (I0b)
Z80_addr_{13}: U1.3 (A_{13}), U10.13 (I1b)
Z80_addr_{14}: U1.4 (A_{14}), U10.15 (I2b)
Z80_addr_{15}: U1.5 (A_{15}), U10.17 (I3b)
Z80_clock: U1.6 (CLK), Y1.5 (OUT)
Z80_data_{0}: U1.14 (D_{0}), U9.2 (I0a), U11.18 (O0a)
Z80_data_{1}: U1.15 (D_{1}), U9.4 (I1a), U11.16 (O1a)
Z80_data_{2}: U1.12 (D_{2}), U9.6 (I2a), U11.14 (O2a)
Z80_data_{3}: U1.8 (D_{3}), U9.8 (I3a), U11.12 (O3a)
Z80_data_{4}: U1.7 (D_{4}), U9.11 (I0b), U11.9 (O0b)
Z80_data_{5}: U1.9 (D_{5}), U9.13 (I1b), U11.7 (O1b)
Z80_data_{6}: U1.10 (D_{6}), U9.15 (I2b), U11.5 (O2b)
Z80_data_{7}: U1.13 (D_{7}), U9.17 (I3b), U11.3 (O3b)
addr_sel_{0}: J1.40, RN1.5 (R4), U3.5 (A1)
addr_sel_{1}: J1.41, RN1.4 (R3), U3.3 (A2)
addr_sel_{2}: J1.42, RN1.3 (R2), U3.14 (A3)
addr_sel_{3}: J1.43, RN1.2 (R1), U3.12 (A4)
bus_addr_{0}: J1.6, J2.6, J3.6, J4.6, J5.6, U5.10 (A0), U6.10 (A0), U8.18 (O0a)
bus_addr_{1}: J1.7, J2.7, J3.7, J4.7, J5.7, U5.9 (A1), U6.9 (A1), U8.16 (O1a)
bus_addr_{2}: J1.8, J2.8, J3.8, J4.8, J5.8, U5.8 (A2), U6.8 (A2), U8.14 (O2a)
bus_addr_{3}: J1.9, J2.9, J3.9, J4.9, J5.9, U5.7 (A3), U6.7 (A3), U8.12 (O3a)
bus_addr_{4}: J1.10, J2.10, J3.10, J4.10, J5.10, U5.6 (A4), U6.6 (A4), U8.9 (O0b)
bus_addr_{5}: J1.11, J2.11, J3.11, J4.11, J5.11, U5.5 (A5), U6.5 (A5), U8.7 (O1b)
bus_addr_{6}: J1.12, J2.12, J3.12, J4.12, J5.12, U5.4 (A6), U6.4 (A6), U8.5 (O2b)
bus_addr_{7}: J1.13, J2.13, J3.13, J4.13, J5.13, U5.3 (A7), U6.3 (A7), U8.3 (O3b)
bus_addr_{8}: J1.14, J2.14, J3.14, J4.14, J5.14, U5.25 (A8), U6.25 (A8), U10.18 (O0a)
bus_addr_{9}: J1.15, J2.15, J3.15, J4.15, J5.15, U5.24 (A9), U6.24 (A9), U10.16 (O1a)
bus_addr_{10}: J1.16, J2.16, J3.16, J4.16, J5.16, U5.21 (A10), U6.21 (A10), U10.14 (O2a)
bus_addr_{11}: J1.17, J2.17, J3.17, J4.17, J5.17, U5.23 (A11), U6.23 (A11), U10.12 (O3a)
bus_addr_{12}: J1.18, J2.18, J3.18, J4.18, J5.18, U3.6 (B1), U5.2 (A12), U6.2 (A12), U10.9 (O0b)
bus_addr_{13}: J1.19, J2.19, J3.19, J4.19, J5.19, U3.2 (B2), U5.26 (A13), U6.26 (A13), U10.7 (O1b)
bus_addr_{14}: J1.20, J2.20, J3.20, J4.20, J5.20, U3.15 (B3), U5.1 (A14), U6.1 (A14), U10.5 (O2b)
bus_addr_{15}: J1.21, J2.21, J3.21, J4.21, J5.21, U3.11 (B4), U7.1 (A0), U10.3 (O3b)
bus_clock: J2.33, J3.33, J4.33, J5.33
bus_data_{0}: J1.24, J2.24, J3.24, J4.24, J5.24, U5.11 (Q0), U6.11 (Q0), U9.18 (O0a), U11.2 (I0a)
bus_data_{1}: J1.25, J2.25, J3.25, J4.25, J5.25, U5.12 (Q1), U6.12 (Q1), U9.16 (O1a), U11.4 (I1a)
bus_data_{2}: J1.26, J2.26, J3.26, J4.26, J5.26, U5.13 (Q2), U6.13 (Q2), U9.14 (O2a), U11.6 (I2a)
bus_data_{3}: J1.27, J2.27, J3.27, J4.27, J5.27, U5.15 (Q3), U6.15 (Q3), U9.12 (O3a), U11.8 (I3a)
bus_data_{4}: J1.28, J2.28, J3.28, J4.28, J5.28, U5.16 (Q4), U6.16 (Q4), U9.9 (O0b), U11.11 (I0b)
bus_data_{5}: J1.29, J2.29, J3.29, J4.29, J5.29, U5.17 (Q5), U6.17 (Q5), U9.7 (O1b), U11.13 (I1b)
bus_data_{6}: J1.30, J2.30, J3.30, J4.30, J5.30, U5.18 (Q6), U6.18 (Q6), U9.5 (O2b), U11.15 (I2b)
bus_data_{7}: J1.31, J2.31, J3.31, J4.31, J5.31, U5.19 (Q7), U6.19 (Q7), U9.3 (O3b), U11.17 (I3b)
rom_address: U3.9 (C4), U7.2 (A1)
rom_select: J1.3, U4.6
~Z80_busack: U1.23 (~BUSACK), U4.12, U4.13, U12.15 (I2b)
~Z80_busreq: J2.38, J3.38, J4.38, J5.38, U1.25 (~BUSREQ)
~Z80_halt: U1.18 (~HALT), U12.17 (I3b)
~Z80_int: J2.40, J3.40, J4.40, J5.40, U1.16 (~INT)
~Z80_iorq: U1.20 (~IORQ), U12.4 (I1a)
~Z80_m1: U1.27 (~M1), U12.11 (I0b)
~Z80_mreq: U1.19 (~MREQ), U12.2 (I0a)
~Z80_nmi: J2.41, J3.41, J4.41, J5.41, U1.17 (~NMI)
~Z80_reset: U1.26 (~RESET), U4.8
~Z80_rfsh: U1.28 (~RFSH), U12.13 (I1b)
~Z80_wait: J2.43, J3.43, J4.43, J5.43, U1.24 (~WAIT)
~bus_busack: J2.39, J3.39, J4.39, J5.39, U12.5 (O2b)
~bus_halt: J2.42, J3.42, J4.42, J5.42, R7.1, U12.3 (O3b)
~bus_iorq: J2.36, J3.36, J4.36, J5.36, U12.16 (O1a)
~bus_m1: J2.34, J3.34, J4.34, J5.34, U12.9 (O0b)
~bus_mreq: J2.35, J3.35, J4.35, J5.35, U7.5 (E2), U12.18 (O0a)
~bus_rd: J1.5, J2.5, J3.5, J4.5, J5.5, U5.22 (~OE), U6.22 (~OE), U12.14 (O2a)
~bus_rfsh: J2.37, J3.37, J4.37, J5.37, U12.7 (O1b)
~bus_wr: J1.4, J2.4, J3.4, J4.4, J5.4, U5.27 (~WE), U6.27 (~WE), U12.12 (O3a)
~ram_0_select: U5.20 (~CS), U7.15 (O0)
~ram_1_select: U6.20 (~CS), U7.14 (O1)

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
Board: 2 copper layers, 42 parts (0 on the bottom side), 91 nets, no tracks yet.
