rcapaverde/z80board/(commit log)

2026-08-08 versão inicial do pcb
    [mainboard.kicad_pcb, mainboard.kicad_sch]
2026-08-21 versão básica da PCB do Z80
    [mainboard_v0.kicad_pcb, mainboard_v0.kicad_sch]
